ZipsRacingElectric/VCU-ZR25-Senior-Design/README.md

# Vehicle Control Unit - ZR25 - Senior Design Project
The VCU contains the control algorithms for the powertrain.

## Todo
See the Issues tab for an up-to-date list.

## Building the project on a demo board

## RTOS Strucutre
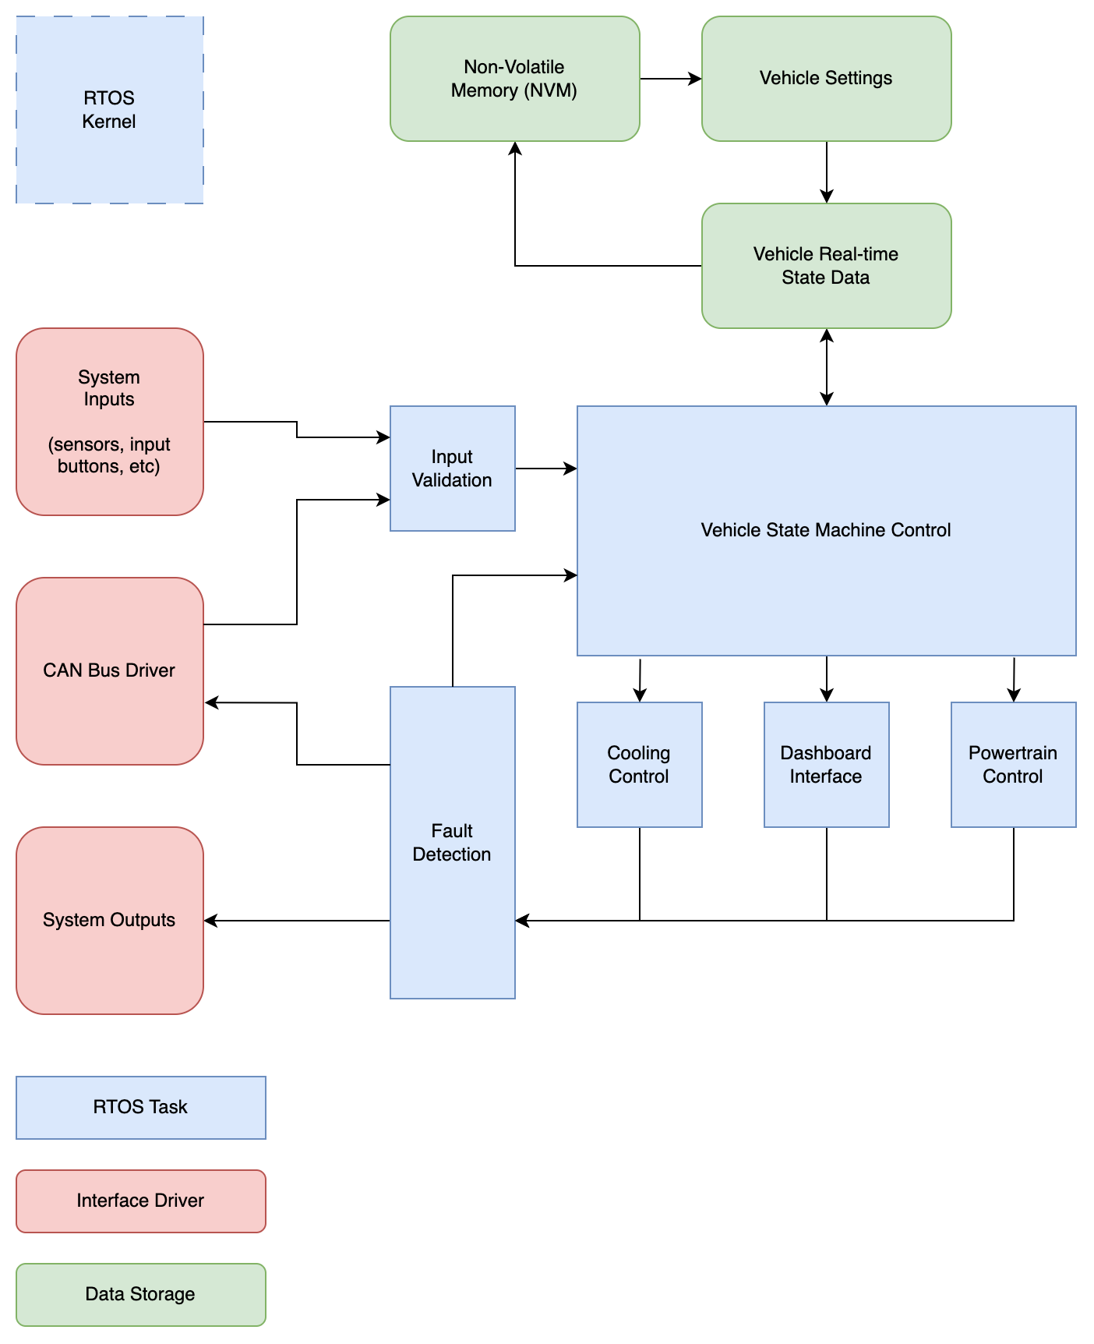
[picture p1: images/Microcontroller State Diagram.png]
RTOS structure for VCU
