ZipsRacingElectric/VCU-ZR25-Senior-Design/demos/powersupply/circuit_sketch.jpg

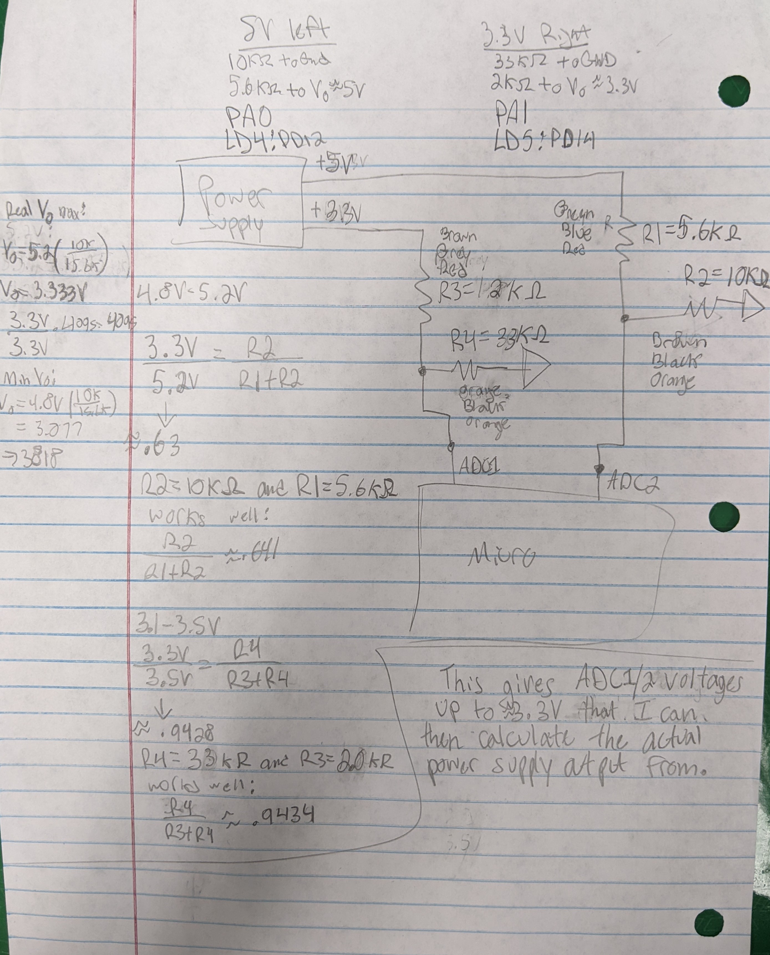
demos/powersupply/circuit_sketch.jpg
