ZipsRacingElectric/VCU-ZR25-Senior-Design/(threads)

Thread 2 (2025-01-28):

State Machine

bglen, 2025-01-28:
Implement State Machine (see flow chart for state machine)

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

- per discussion, eliminate lockout state

- in 1, the two conditions are 3.3V_SHUTDOWN_LOOP_IN must be logic high, and no faults. No faults can be determined by checking if the variable that controls ~3.3V_VCU_FAULT is logic low. Note that in the Low Voltage State, ~3.3V_VCU_FAULT can be either logic 1 or 0.

- in 2, the start signal is 3.3V_START_BUTTON_INPUT. Also, for the braking condition, the sensor driver code should have a variable that is true if the brakes are pressed hard enough and the line pressure is above a certain threshold.

- the 3 operation is really two separate operations:

   1: Under normal operation, one of the E-stops is opened. Per the shutdown loop diagram below, this will drop the 3.3V_SHUTDOWN_LOOP_IN signal low, indicating that the VCU should be put in Low Voltage State. The VCU should not change the  ~3.3V_VCU_FAULT signal (keeping it logical 1, and the relay stays closed).

   2: If a fault is detected, the ~3.3V_VCU_FAULT goes logic low, opening the relay. this causes the vehicle high voltage to turn off, and the VCU should be put into Low Voltage State.  3.3V_SHUTDOWN_LOOP_IN may either be logical 1 or 0 in this condition.

- The relay essentially is only opened by the presence of a fault, and can only be closed via the presence of the 3.3V_SHUTDOWN_LOOP_RESET signal.

- 4 no longer relevant.

Shutdown Loop wiring in vehicle:

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

purifiedbagels, 2025-02-20:
Updated the state machine, removed 4 and 5, updated wording of 3

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

purifiedbagels, 2025-02-22:
@bglen Is "driver presses the brakes" the mechanical brakes engaged that you reference in #9 or is it based on the same threshold as the brake light

purifiedbagels, 2025-03-11:
Pseudo-tested with manually setting flags via callbacks, works in itself and dependent on other tasks working properly

Closed 2025-03-11.

Thread 3 (2025-01-28):

CAN Control - Inverter / Motors

bglen, 2025-01-28:

bglen, 2025-03-08:
@tetrahedron341 Update on CAN bus network layout:

Plan on using one of the CAN transiever networks soley for communication between VCU and the 4 inverters - this is due to their "finicky" nature and tendancy of giving can message errors with other stuff on the bus.

The second CAN bus will have everything else on it, including the datalogging node. This means that the VCU will eventually need to act as a bridge and re-transmit inverter CAN messages onto the second bus. Besides the datalogger, the only other node that may use inverter messages might be the dashboard.

Both buses will have the VCU be the starting node, so both terminations will be active.

Thread 4 (2025-01-28):

I2C - Get steering angle sensor working

bglen, 2025-01-28:
Demo code never worked - may be due to bad steering angle sensor PCB

bglen, 2025-02-22:
[AM4096D02_09 (2).pdf](https://github.com/user-attachments/files/18917455/AM4096D02_09.2.pdf)

[slva689 (1).pdf](https://github.com/user-attachments/files/18917456/slva689.1.pdf)

Cole mentioned that the device is configured via I2C, but I should check if it can also be read through I2C

purifiedbagels, 2025-04-02:
any update on this?

Thread 9 (2025-02-18):

Control of motor torque from driver input plausibility

bglen, 2025-02-18:
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

- APPS pedal percent accessed through struct APPSSensor_t.percent that is returned from get_apps_data(void) function
- The brake threshold required to meet the "mechanical brakes engaged" requirement is not directly defined in the rules, so that is up to us to decide. Generally it should be pretty high so we don't trigger this while driving, but low enough so this functionality can be tested easilly. Probably around 50-75% of the max brake pressure.
- A bool variable checking for brake threshold is not currently part of the BPSSensor_t struct. This functionality should be added to driver_sensors.c

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
For APPS sensors:
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

- bool variables for plausibility are accessed through APPSSensor_t & BPSSensor_t structs returned from get_apps_data(void) and bool plausible
- In the past we've used the 100 ms delay between an implausibility & reducing motor torque requests as a way to avoid accidentally shutting down motors from plausibility issues caused by analog signal noise
- Generally, when a plausibility is detected, a 100 ms timer is started. Until then, motor torque control still uses the sensor outputs. If plausibility goes away, timer is reset
- The VCU fault does not need to be triggered, as this would open the shutdown loop and require a vehicle reset.

bglen, 2025-02-18:
Note: this functionality is separate from any torque vectoring control, so it could be part of a fault checking task, or torque command verification that comes after TV.

bglen, 2025-02-22:
> for the plausability - if the VCU fault doesn't need to be triggered then how is the shutdown loop being opened? I thought the way for the VCU to open the shutdown loop was with VCU fault

Correct, it would not open the shutdown loop. I should clarify that is the desired functionality in this case; a pedal plausibility issue will just cause the torque request CAN message sent to the inverter to be 0 Nm for each motor, but the high voltage will still be active.

bglen, 2025-02-22:
Faults which open the shutdown loop relay and faults that do not should be clarified in a table in #13

Closed 2025-04-02.

Thread 13 (2025-02-20):

Fault Checking Task

purifiedbagels, 2025-02-20:
There should probably be a separate RTOS task that handles fault checking

- Should be given information by various sensor tasks to determine faults
- Talks to fsm and/or vehicle data to determine state transitions and pin outputs

bglen, 2025-02-22:
I imaging #9 would be one of many checks that are carried out in this fault task?

bglen, 2025-02-22:
TODO: create a table of faults, determine which ones should open the shutdown loop, which should not, and what the expected functionality should be for each fault condition

bglen, 2025-03-16:
[VCU Faults.xlsx](https://github.com/user-attachments/files/19274600/VCU.Faults.xlsx)

purifiedbagels, 2025-03-17:
I will work on adding these

Thread 14 (2025-02-20):

Engineering Requirements Not Addressed

purifiedbagels, 2025-02-20:
List of engineering requirements yet to be addressed - implemented or not in issues:

- **1.1.9** The system shall provide a method of switching between different “control modes” for the powertrain, which can be selected by the driver (See Table 27 in Appendices).
- **1.1.11** Per FSAE rule T.3.4 the system shall activate a brake light on the rear of the vehicle based on of the following conditions... _(should be addressed when updating driver_sensors.c and/or fault detection_
- **1.1.12** The system shall control water pump(s) and radiator fan(s) associated with the vehicle’s cooling system in the following ways...
- **1.1.13** The system shall not command the powertrain to draw more than 80 kW of power from the high voltage battery output terminals, per FSAE 2025 rule EV.3.3.1 & EV3.4.1. _(not sure how we do this)_
- **1.1.15** The system shall be no larger than L x W x H (TBD#5) and the system's total mass shall not exceed (TBD#6) kg. _(is this already done?)_
- **1.1.16 - 1.1.18** Are these electrical things already done?
- **1.1.19** The system shall record and store its settings (tuning parameters, etc.) across power cycles. _(I'm assuming the VCU has to store in memory)_
- **1.1.21** Real-Time Processes _referring to update rates_
- **1.1.22** I believe we're on our way with all of these
- **1.1.23** The system shall be waterproof. _(is this also already done?)_

These are the ones I believe aren't totally addresses or that I just don't know of. Thoughts in italics

bglen, 2025-02-22:
I've added these requirements to the relevant issues.

- For 1.1.13, the torque vectoring algorithm selected by the torque control handler/task will be responsible for this (AKA Ryan and my will address this in the control system)
- 1.1.15 I thought we removed, but essentially yes it will fit in the vehicle. I don't have specific dimensions or weight requirements
- 1.1.19 will need to be addressed in the tasks handling vehicle data. Just a heads up - the control algorithms will require some lookup tables stored in memory. These tables will hold data like controller gains, tire forces, and electric motor power losses. Most of these tables are "set and forget" and can be sent to memory like flash. Some will be tuning parameters that may be written multiple times, so EEPROM or other kinds of memory that can handle a lot of write cycles may be more appropriate. We will also have to determine how to load this data onto the micro (i.e, reprogram or send it over CAN / USB C, etc..)

Closed 2025-04-02.

Thread 15 (2025-02-21):

Dashboard Interface Task

purifiedbagels, 2025-02-21:

bglen, 2025-02-21:
For basic functionality:
- the VCU will not communicate with the MoteC LCD display. Instead, any data this display needs, it will grab it from the data-logging messages on the CAN bus through its own programming.

**Start button input (3.3V_START_BUTTON_INPUT):**
- used for entering Ready to Drive mode

**Dashboard VCU Fault LED (3.3V_DASH_INPUT_1):**
- There is an LED on the dash that can light up whenever there is a VCU fault we want to display. 3.3V_DASH_INPUT_2 technically should be configured as a digital output for this. Whenever there is a fault that triggers the ~3.3V_VCU_FAULT opening the shutdown loop relay, we should turn this LED on also so we can debug what happened.
- The reason we don't send the ~3.3V_VCU_FAULT signal directly to this LED is because there might be a minor fault (APPS for example), that we want to trigger the LED but don't want the shutdown loop relay opening and causing the car to fall out of high voltage.

**DRS enable / disable button (3.3V_DASH_INPUT_2):**
- This allows the driver to toggle the drag reduction system. The VCU will have to keep track of the DRS enable state, and change it when this button is pressed.
- The DRS system is on a separate board connected to the CAN bus. The VCU will have to send a CAN message over the bus when the DRS enable state changes. (TBD) I don't know if this message is supposed to get sent at a regular interval, or only when the state changes (and some kind of handshake is done).
- The DRS state can be toggled regardless of the VCU state.

**Torque limit Increase button (3.3V_DASH_INPUT_3):**
- When pressed the torque limit variable increases by some percentage (lets say 10% for now)
- The torque limit variable will be part of the torque control handler, is a percentage 0 to 100% that gets passed to whatever algorithm is calculating the motor torques.
- torque limit variable should be limited between 10 to 100%. It might just be an integer that is interpreted by the algorithm as a percentage.

**Torque limit decrease button (3.3V_DASH_INPUT_4):**
- When pressed the torque limit variable decreases by some percentage (lets say 10% for now)

purifiedbagels, 2025-02-22:
@bglen I'd assume that if the shutdown loop opens externally, we should also turn on DASH_INPUT_2?
Actually thinking about this more, how does this work with configuring input 2 as an output for the VCU fault but as an input otherwise. It can only be one at a time, so do we assume that the dashboard will just keep the LED on even when we have to switch it back to an input, where the signal would go low?

purifiedbagels, 2025-02-22:
Yeah I'm a bit confused. The schematics show that the dash inputs are actual inputs, but 1 is an output and 2 sometimes is?

bglen, 2025-02-24:
That was a mistake, under **Dashboard VCU Fault LED (3.3V_DASH_INPUT_1):** I meant to write 3.3V_DASH_INPUT_1

The schematic calls these signals inputs, but in reality I should update it and call them GPIO as they can serve a more general purpose other than button inputs

purifiedbagels, 2025-02-24:
@tetrahedron341 Issue closed besides CAN

Closed 2025-04-02.

Thread 16 (2025-02-21):

Cooling System Task

purifiedbagels, 2025-02-21:

bglen, 2025-02-21:
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

4 outputs to control:
- 3.3V_PUMP_1_CONTROL
- 3.3V_PUMP_2_CONTROL
- 3.3V_FAN_1_CONTROL
- 3.3V_FAN_2_CONTROL

For now lets arbitrarily say that:
-  Pump 1 / Fan 1 cool the left side inverter & 2 left motors
-  Pump 2 / Fan 2 cool the left side inverter & 2 left motors

bglen, 2025-02-21:
Cooling system control:

All Pumps & Fans are turned on in the following conditions:
- The vehicle is in the Ready to Drive state

Pumps 1 /  Fan 1 can only turn off in the  following conditions:
- The left inverter temp drops below X, &
- The FL motor temp drops below X, &
- The RL motor temp drops below X

Pumps 2 /  Fan 2 can only turn off in the  following conditions:
- The right inverter temp drops below X, &
- The FR motor temp drops below X, &
- The RR motor temp drops below X

The idea is that if one of these components is overheated, we still want to cool it even if we turn the high voltage off.

bglen, 2025-02-21:
The temperature data is sent over the CAN bus in the following messages, which are sent every 16? Hz:

RL Inverter / Motor, CAN ID 0x500
RR Inverter / Motor, CAN ID 0x501
FL Inverter / Motor, CAN ID 0x502
FR Inverter / Motor, CAN ID 0x503

- Temperature sensor motor is the motor temp
- IGBT temperature is the inverter temp
- Temp internal and external should be ignored (not sure what these are)

see the CAN config table: https://github.com/ZipsRacingElectric/AMK-2025

purifiedbagels, 2025-02-21:
is the temperature being read by CAN? I don't see a pin for it

purifiedbagels, 2025-02-22:
@tetrahedron341 this is pretty CAN related, I wrote an outline and can do the GPIO side but you should do the CAN as I'm not familliar

bglen, 2025-02-22:
Scaling factors for the message data should be found in the inverter documentation; it should eventually be added as a column to the table in the AMK-2025 README.md

bglen, 2025-02-22:
Note: I forgot to include the additional condition in one of the above comments:

Each Pump/Fan pair should turn on if the inverters / motors they cool are above a certain temperature, regardless of VCU state. This is to catch the edge case where the car exits high voltage, the powertrain is still hot, so the cooling system is working, and then someone cycles low voltage power, causing the VCU to reset. In this case we want the cooling system to turn back on.

bglen, 2025-02-24:
TODO: figure out temperature setpoints

Closed 2025-04-02.

Thread 17 (2025-02-21):

Torque Control Task

purifiedbagels, 2025-02-21:
@bglen Not really sure what this entails and if this is on your end or Tetra and I's

bglen, 2025-02-21:
So for a first iteration:

This can be a placeholder for the future TV algorithm by simply scaling the APPS pedal percentage by a max torque variable to get the torque request. This can then be applied to each motor equally.

Next iteration:
- We will want to have multiple algorithms that we can select. One would essentially be the simple algorithm mentioned above, which we can call a limp mode
- Next we would have the torque vectoring algorithm. This probably will be some function or class with a PID implementation.
- For the handler that selects the algorithm, it would be a good idea to pass each algorithm a struct containing all the vehicle data the algorithm needs to compute. We could make this struct the same for all algorithms, and simpler controllers just wouldn't use all the data.

bglen, 2025-02-21:
From engineering requirements:

1.1.9 The system shall provide a method of switching between different “control modes” for the powertrain, which can be selected by the driver (See Table 27 in Appendices).

bglen, 2025-02-22:
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

First attempt at the kind of data we would want to pass to the control algorithm in an input struct (or with multiple structs). I've put this spreadsheet Torque Control Struct.xlsx on the DT10 drive and will update it as we figure it out.

I can also see an initialization struct being used to send constant data needed by the control algorithms (things like constant vehicle parameters, like mass). Could also just be hard coded.

purifiedbagels, 2025-02-24:
instead of creating a new struct, it's likely that this will all be in the vehicledata struct that the algorithm can get

purifiedbagels, 2025-04-02:
closing because this is no longer specifically different from the #19

Closed 2025-04-02.

Thread 18 (2025-02-21):

Brake Light Functionality

bglen, 2025-02-21:
from engineering requirements:

1.1.11 Per FSAE rule T.3.4 the system shall activate a brake light on the rear of the vehicle based on of the following conditions... (should be addressed when updating driver_sensors.c and/or fault detection

- Not sure if this needs a separate RTOS task or can be part of an existing one (driver sensor handling for example)
- Must operate regardless of VCU state
- trigged by the brake pressure exceeding a certain threshold that is stored in driver_sensors.c
- this brake pressure threshold should NOT the same as the one discussed in #9 - that threshold will be too high. Instead this one can be low, like 5% of maximum brake pressure
- Toggle 3.3V_BRAKE_LIGHT_CONTROL to active brake light circuit

Closed 2025-02-22.

Thread 19 (2025-02-24):

Torque Vectoring Algorithm

bglen, 2025-02-24:
Created this to separate implementation of the actual torque vectoring algorithm and the RTOS task that runs the algorithm

bglen, 2025-03-22:
**Torque Optimization**

Storage of Tire Model lookup tables, Electric motor power loss lookup tables

bglen, 2025-04-06:
**Reference Yaw Rate Calculation**

- [ ] Implement tetra's LUT interpolation functions for the steering angle LUT
- [ ] in MATLAB convert the steering LUT to directly use radians, get rid of conversion functions
- [ ] Update ref_gen.h ref_gen.c in HIL_test to use vehicle_data
- [ ] Algorithm for calculatign longitudinal acceleration reference value

bglen, 2025-04-06:
**PID Implementation**

- [ ] Gain scheduling using the gain LUT
- [ ] Integrator anti-windup

Thread 21 (2025-02-27):

Vehicle Data Task

bglen, 2025-02-27:
Not entire sure what the plan to implement this is, so edit as necessary:

1. Data collection via CAN bus and input drivers
2. Data filtering / saturation

bglen, 2025-03-16:
**GPS**
Need to capture and record data from the GPS to be used by the control system

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

Data that is relevant to us and should be grabbed from the messages:
- Speed (needs to be converted to m/s)
- GPS Status
- Heading motion (convert to rad)
- Heading vehicle (convert to rad)
- Z angle rate (this is yaw rate, convert to rad/s)
- X acceleration (convert to m/s^2)
- Y acceleration (convert to m/s^2, and invert to put it in the control system coordinate system)

Notes:
- some of the data will be signed
- these messages will be sent at 200 Hz from GPS
- It is very important that we keep track of the GPS status in the 2nd message. It may take like 20 seconds after the car is turned on for the GPS to get a good lock, and then we can reliably use the data to drive. The VCU should trigger a fault that turn the fault LED on the dash on until the GPS lock is found (fault LED is triggered by 3.3V_DASH_INPUT_1)

[ECUMaster GPStoCAN V2 Manual (1).pdf](https://github.com/user-attachments/files/19274239/ECUMaster.GPStoCAN.V2.Manual.1.pdf)

bglen, 2025-03-16:
**MoTeC VIM**

[todo]

bglen, 2025-03-16:
**Battery Management System**

bglen, 2025-03-16:
**Initialization of vehicle data values**

Before data is populated from sensors, we could:
1. initialize everything to 0. We would have to avoid dividing by zero from calling functions before real data gets populated (ex: enabling control algorithm and passing 0 data to it)
2. initialize everything to NaN (from math.h). Then our math functions, specifically torque handling task would check if passed data is NaN via isnan() and handle the exception. We could also pass NaN when a sensor faults (ex: out of bounds)

purifiedbagels, 2025-03-17:
A vehicledata task has been started that all tasks call to to update the data, will need to be updated based on this issue and I think a lot of what is left to store is from CAN. Fault mgmt task can check this data for faults

Thread 29 (2025-04-06):

HIL Test Firmware Tasks

bglen, 2025-04-06:
HIL Test to verify the process works with a test model
- [ ] Initialize PID controller & Can bus @ 1 Mbps
- [ ] Receive CAN message w/ ID 0x123 containing  input_data, output_data, time_step and assign variables
- [ ] Run PID loop, compute controller output
- [ ] Send CAN message w/ ID 0x124 containing controller output

bglen, 2025-04-06:
HIL Test with Yaw Controller

- [ ] Update Receive Message(s) with input data
- [ ] Create Lookup tables for steering system and PI gains
- [ ] Lookup table functions, including interpolation of 1D tables
- [ ] Implement Reference Generation Algorithm
- [ ] Implement PI Controller with gain scheduling
- [ ] Update output message with controller output Mz_tv
