ZipsRacingElectric/VCU-ZR25-Senior-Design/docs/VCU Schematic.pdf

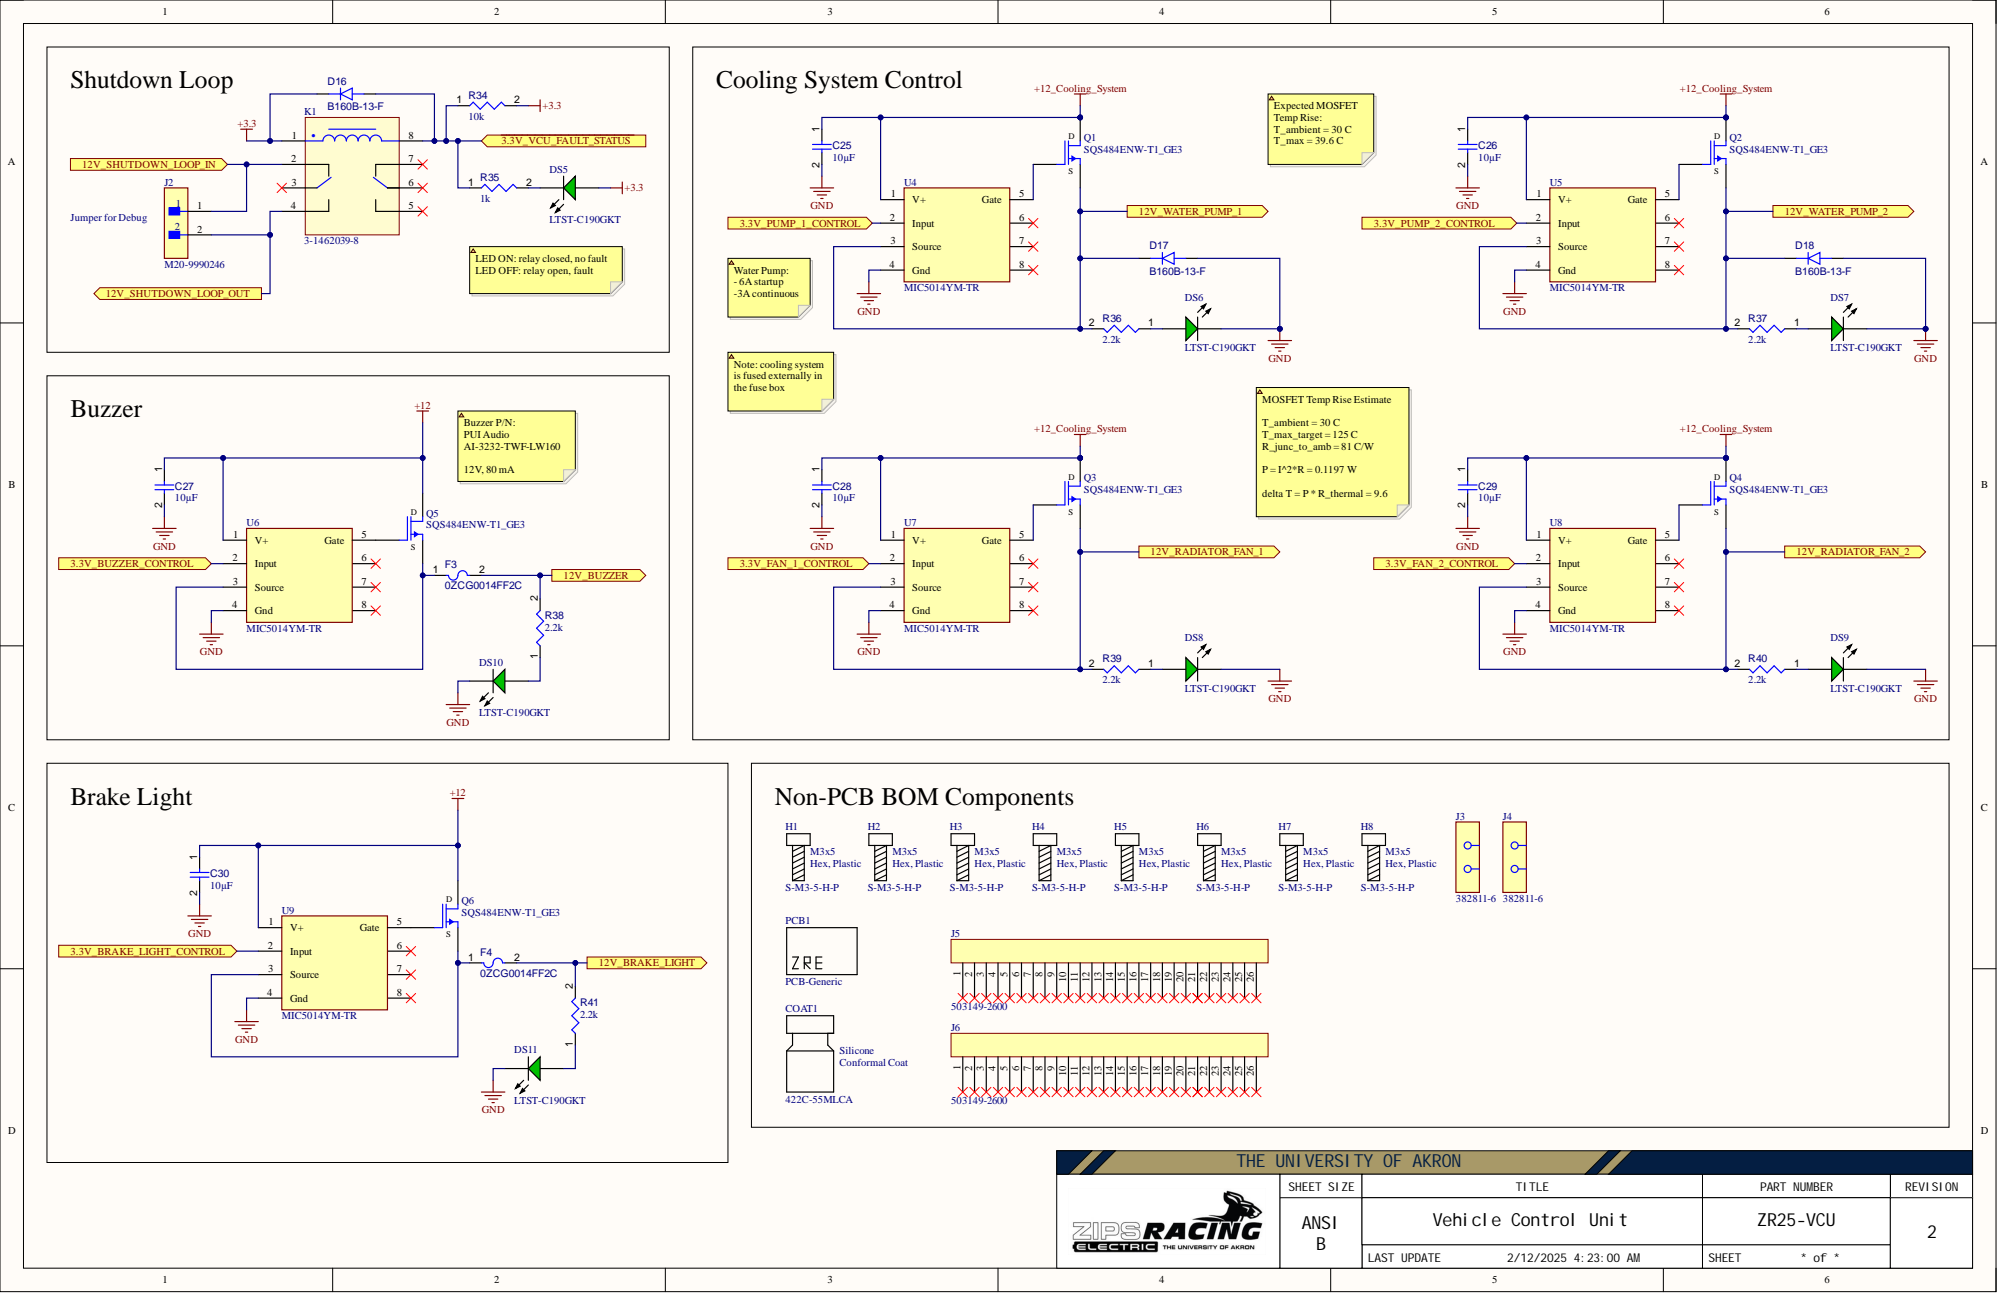
[picture p3: page 1]

LED ON: relay closed, no fault
LED OFF: relay open, fault

Note: cooling system
is fused externally in
the fuse box

MOSFET Temp Rise Estimate

Non-PCB BOM Components

THE UNIVERSITY OF AKRON

SHEET SIZE | TITLE | PART NUMBER | REVISION
ANSI B | Vehicle Control Unit | ZR25-VCU | 2

LAST UPDATE 2/12/2025 4:23:00 AM | SHEET * of *

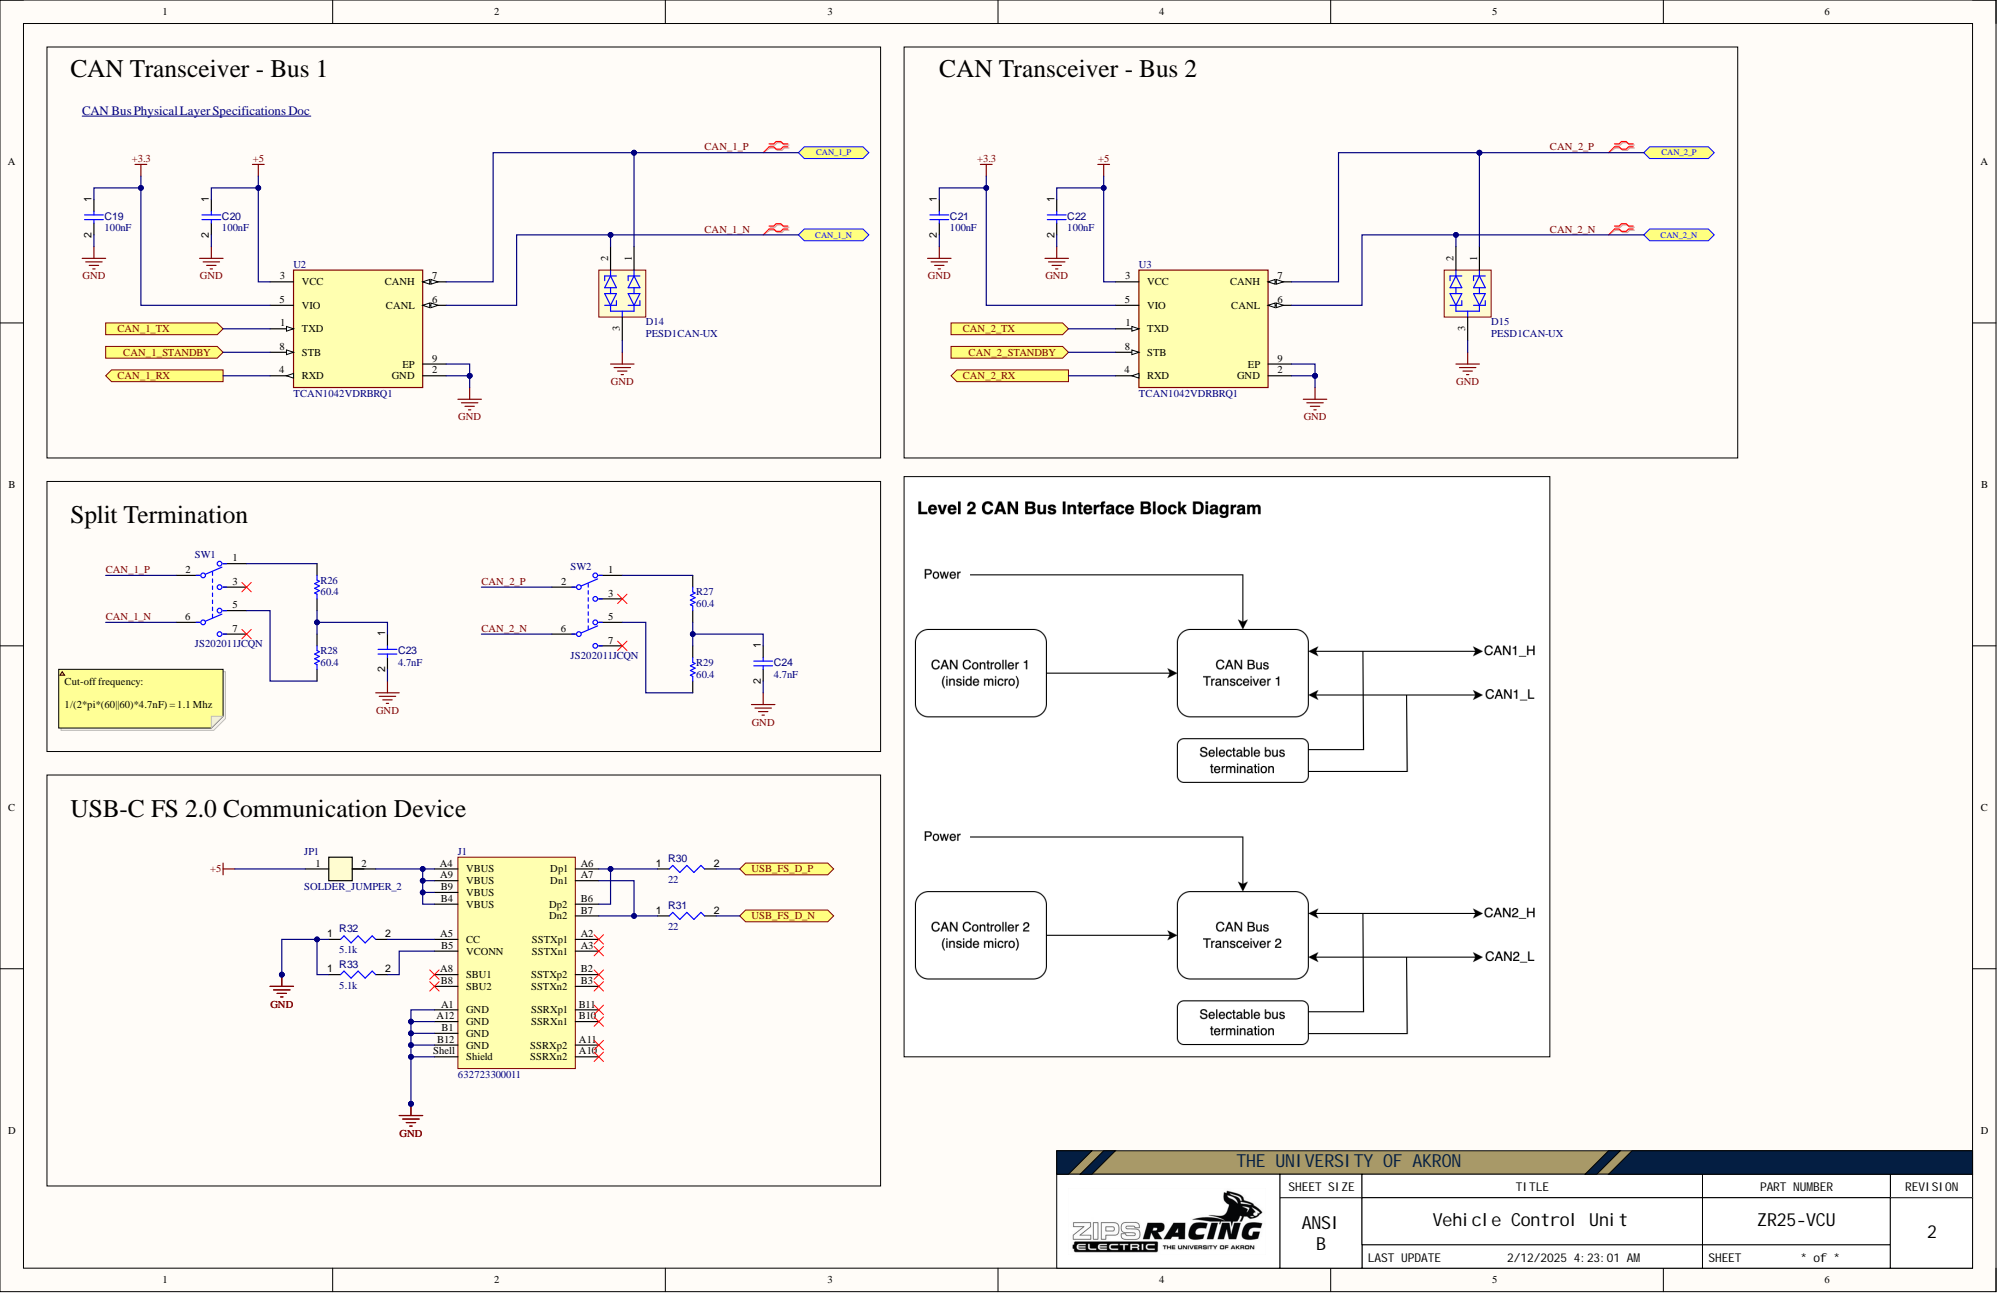
[picture p4: page 2]

CAN Bus Physical Layer Specifications Doc (https://www.ti.com/lit/pdf/slla270)

USB-C FS 2.0 Communication Device

THE UNIVERSITY OF AKRON

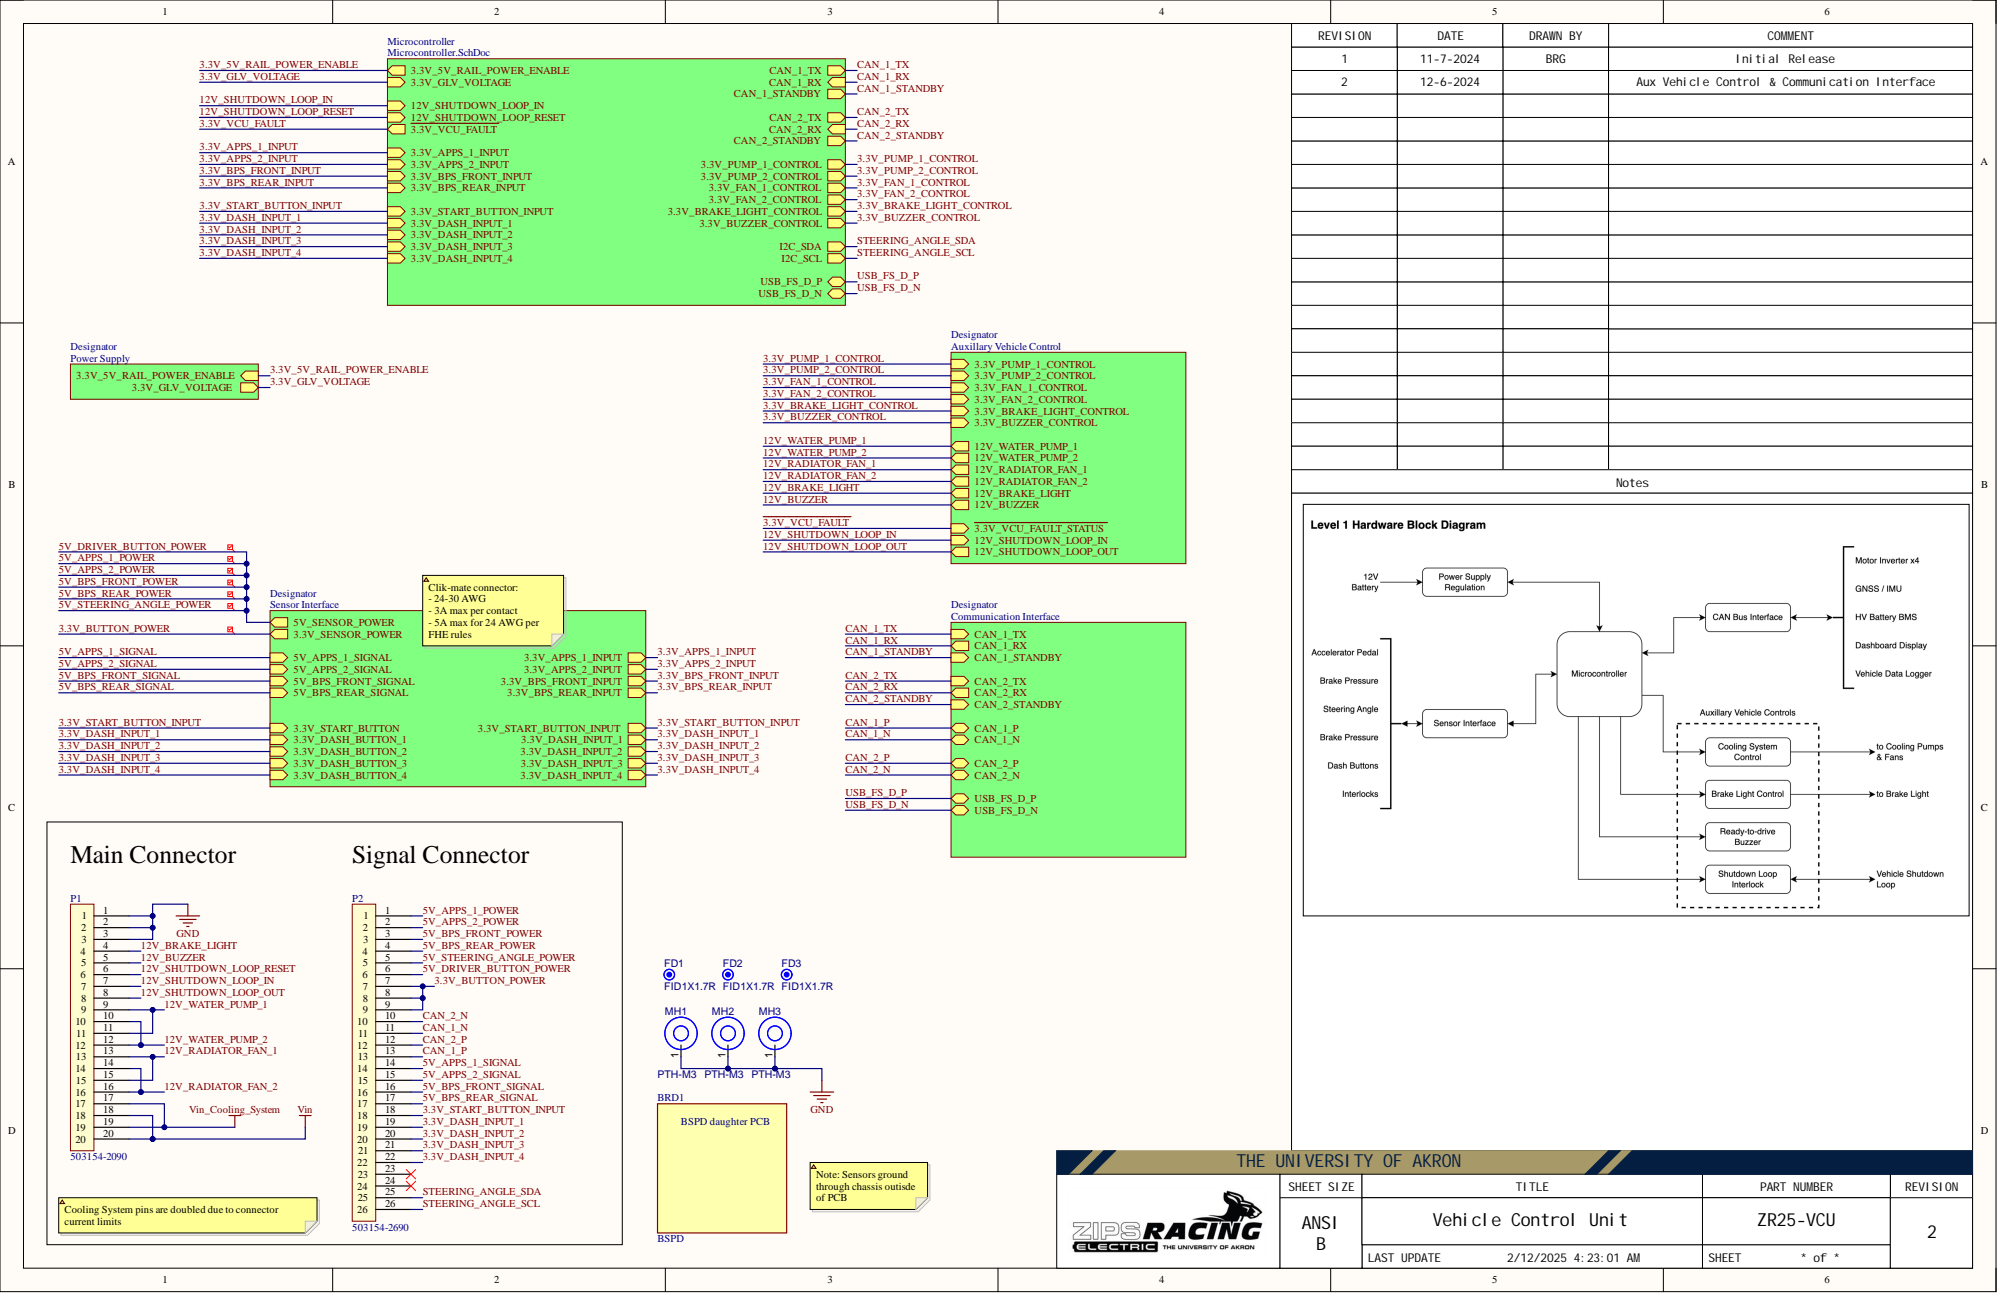
[picture p5: page 3]
Power Supply; Sensor Interface; Communication Interface; Auxillary Vehicle Control; Main Connector; Signal Connector

REVISION | DATE | DRAWN BY | COMMENT

11-7-2024 | BRG | Initial Release

12-6-2024 | | Aux Vehicle Control & Communication Interface

Clik-mate connector:
- 24-30 AWG
- 3A max per contact
- 5A max for 24 AWG per
FHE rules

BSPD daughter PCB

THE UNIVERSITY OF AKRON

Note: Sensors ground
through chassis outisde
of PCB

Cooling System pins are doubled due to connector
current limits

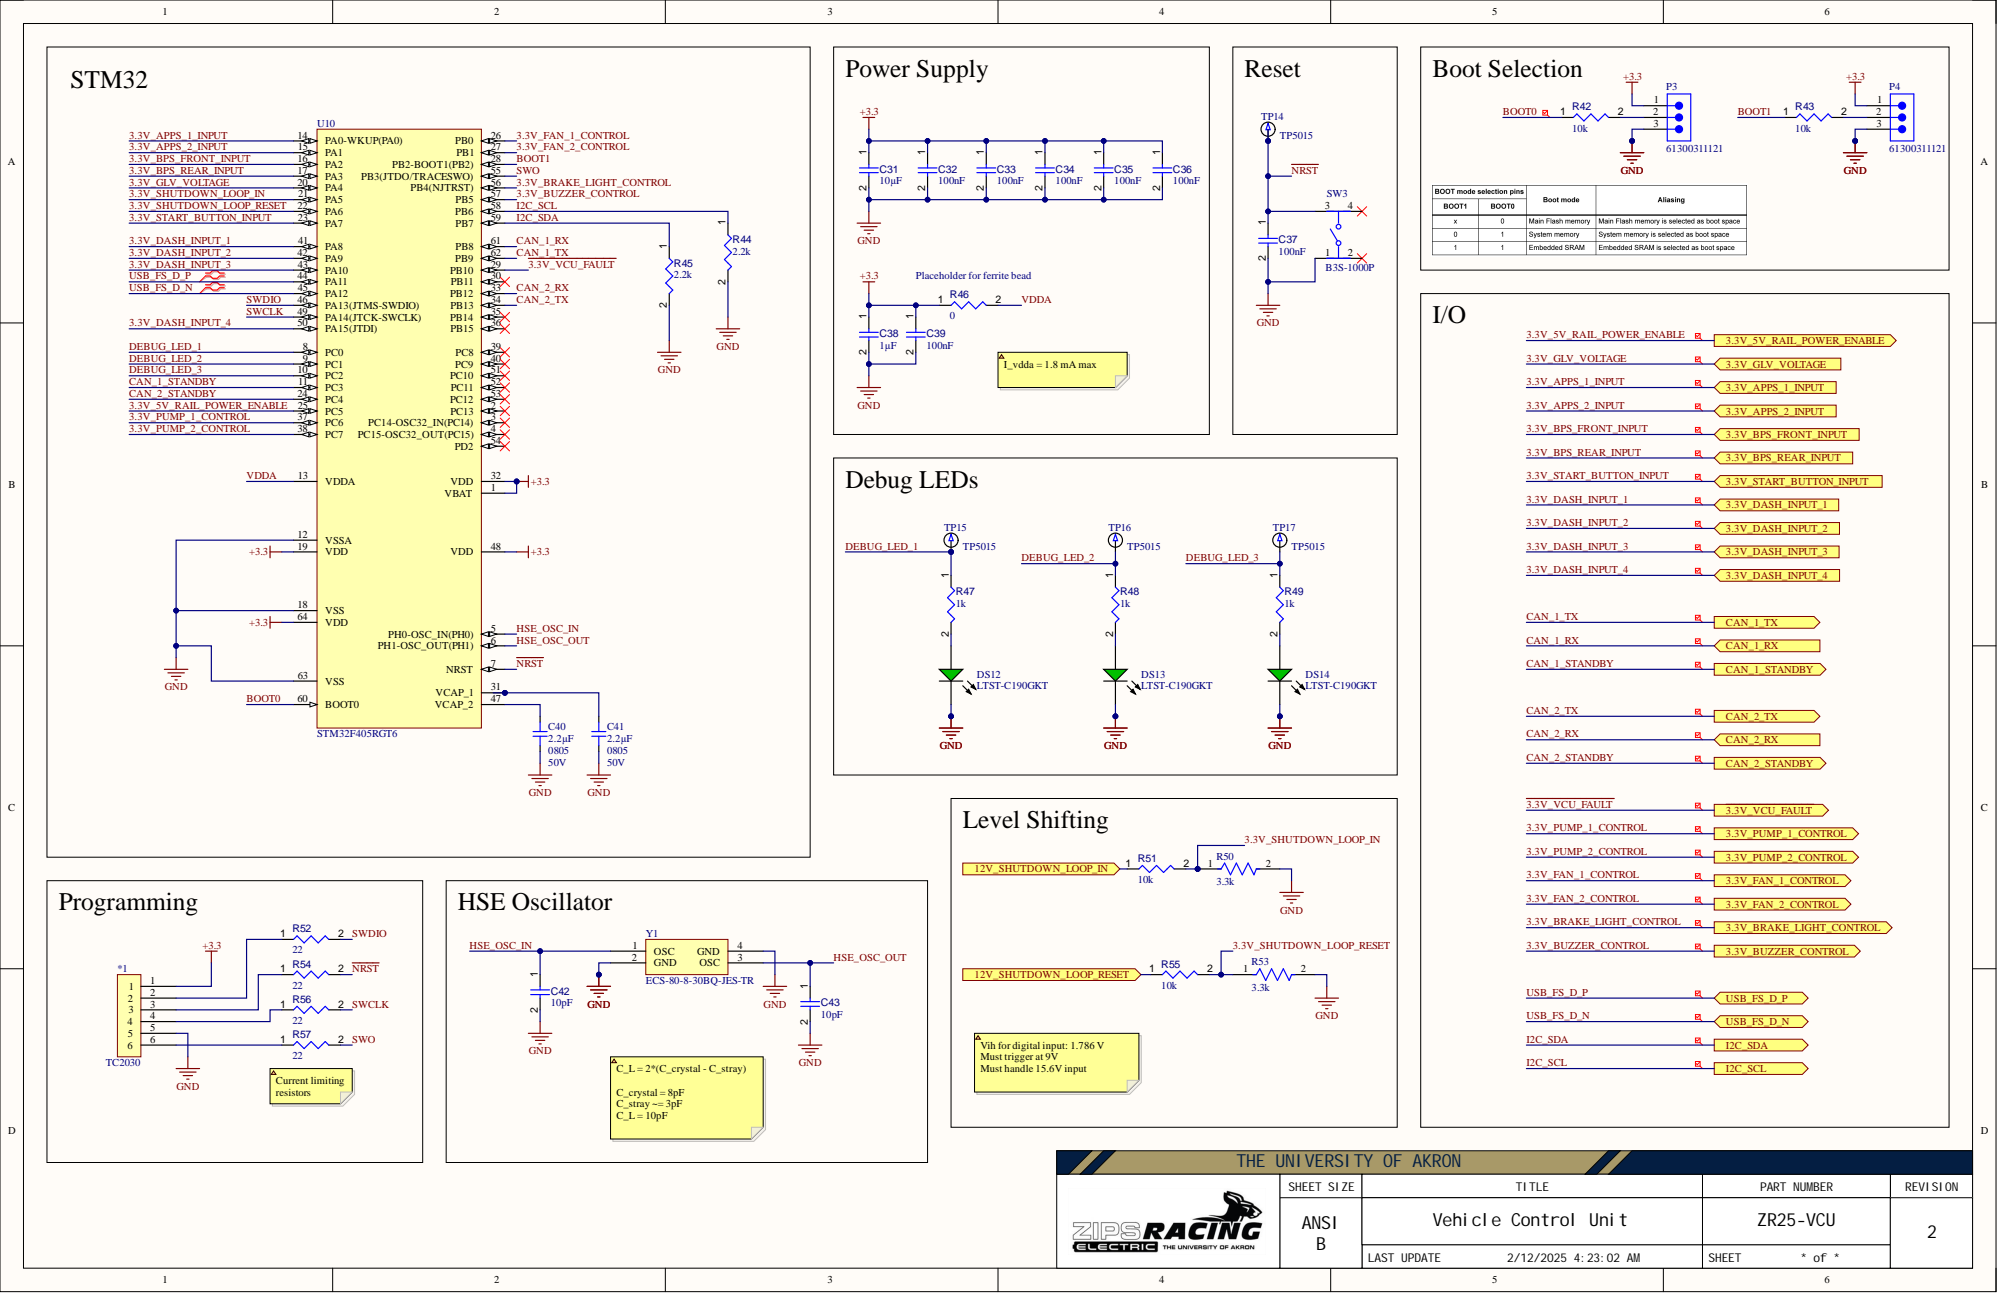
[picture p6: page 4]

Placeholder for ferrite bead

VDD 19

VDD 64

Vih for digital input: 1.786 V
Must trigger at 9V
Must handle 15.6V input

THE UNIVERSITY OF AKRON

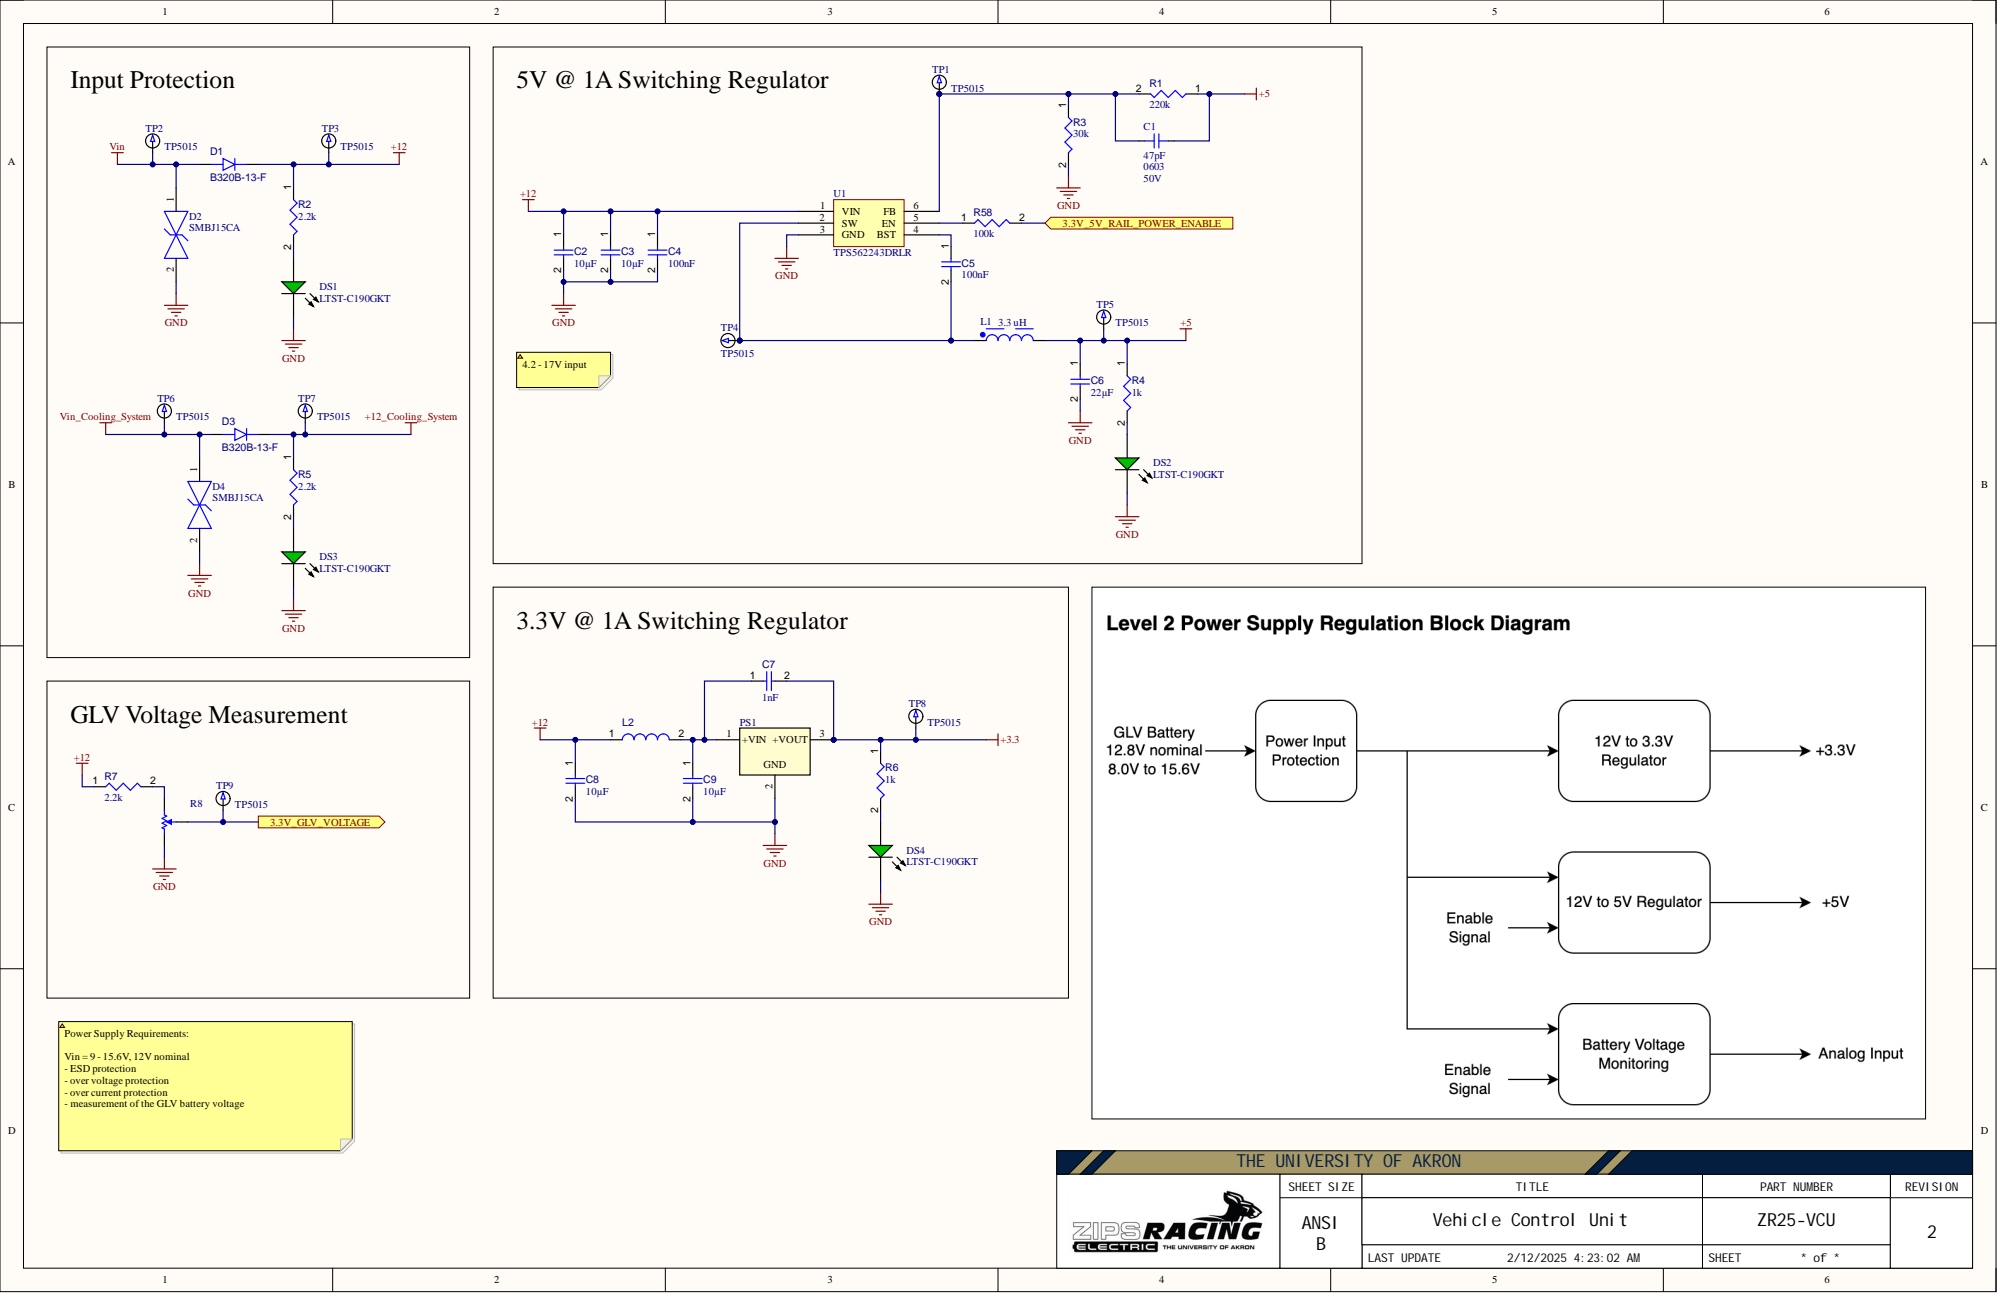
[picture p7: page 5]

Vin = 9 - 15.6V, 12V nominal
- ESD protection
- over voltage protection
- over current protection
- measurement of the GLV battery voltage

THE UNIVERSITY OF AKRON

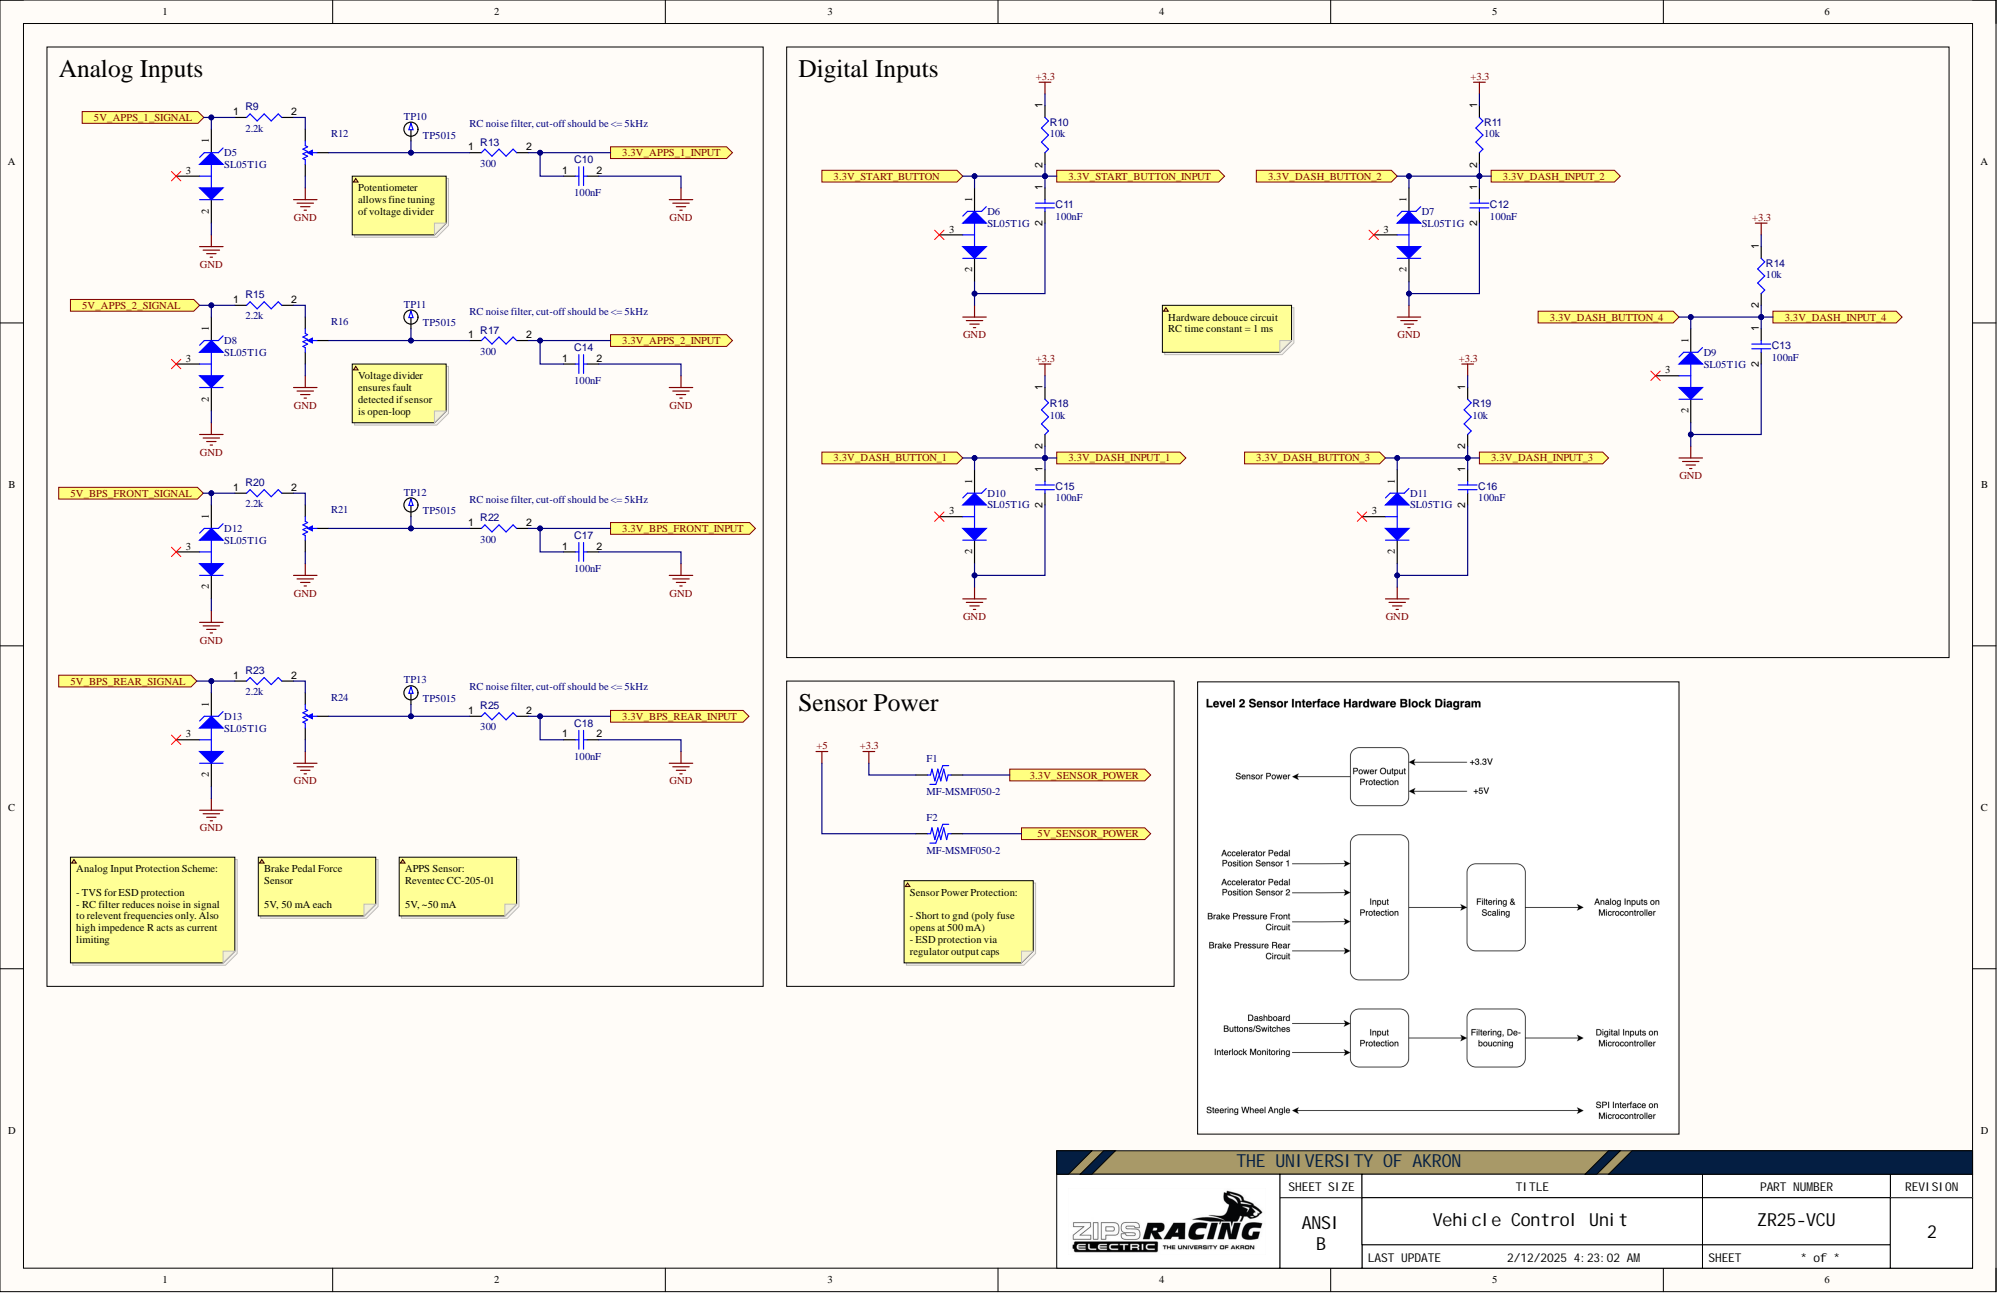
[picture p8: page 6]

RC noise filter, cut-off should be <= 5kHz

Hardware debouce circuit
RC time constant = 1 ms

Analog Input Protection Scheme:

- TVS for ESD protection
- RC filter reduces noise in signal
to relevent frequencies only. Also
high impedence R acts as current
limiting

- Short to gnd (poly fuse
opens at 500 mA)
- ESD protection via
regulator output caps

THE UNIVERSITY OF AKRON
