ZipsRacingElectric/VCU-ZR25-Senior-Design/VCU-ZR25/VCU-ZR25.ioc

Mcu.UserName=STM32F405RGTx
PA0-WKUP.GPIO_Label=APPS_1
PA0-WKUP.Signal=ADCx_IN0
PA1.GPIO_Label=APPS_2
PA1.Signal=ADCx_IN1
PA10.GPIO_Label=DASH_INPUT_3
PA10.Signal=GPXTI10
PA11.Signal=USB_OTG_FS_DM
PA12.Signal=USB_OTG_FS_DP
PA13.Signal=SYS_JTMS-SWDIO
PA14.Signal=SYS_JTCK-SWCLK
PA15.GPIO_Label=DASH_INPUT_4
PA15.Signal=GPXTI15
PA2.GPIO_Label=BPS_FRONT
PA2.Signal=ADCx_IN2
PA3.GPIO_Label=BPS_REAR
PA3.Signal=ADCx_IN3
PA4.GPIO_Label=GLV_BATTERY
PA4.Signal=ADCx_IN4
PA5.GPIO_Label=VCU_SHUTDOWN_LOOP_IN
PA5.Signal=GPXTI5
PA6.GPIO_Label=VCU_SHUTDOWN_LOOP_RESET
PA6.Signal=GPXTI6
PA7.GPIO_Label=START_BUTTON
PA7.Signal=GPXTI7
PA8.GPIO_Label=DASH_INPUT_1
PA8.Signal=GPIO_Output
PA9.GPIO_Label=DASH_INPUT_2
PA9.Signal=GPXTI9
PB0.GPIO_Label=FAN_1_CONTROL
PB0.Signal=GPIO_Output
PB1.GPIO_Label=FAN_2_CONTROL
PB1.Signal=GPIO_Output
PB10.GPIO_Label=VCU_FAULT
PB10.Signal=GPIO_Output
PB12.Signal=CAN2_RX
PB13.Signal=CAN2_TX
PB2.GPIO_Label=BOOT_1
PB2.Signal=GPXTI2
PB3.Signal=SYS_JTDO-SWO
PB4.GPIO_Label=BRAKE_LIGHT_CONTROL
PB4.Signal=GPIO_Output
PB5.GPIO_Label=BUZZER_CONTROL
PB5.Signal=GPIO_Output
PB6.Signal=I2C1_SCL
PB7.Signal=I2C1_SDA
PB8.Signal=CAN1_RX
PB9.Signal=CAN1_TX
PC0.GPIO_Label=DEBUG_LED_1
PC0.Signal=GPIO_Output
PC1.GPIO_Label=DEBUG_LED_2
PC1.Signal=GPIO_Output
PC2.GPIO_Label=DEBUG_LED_3
PC2.Signal=GPIO_Output
PC3.GPIO_Label=CAN_1_STANDBY
PC3.Signal=GPIO_Output
PC4.GPIO_Label=CAN_2_STANDBY
PC4.Signal=GPIO_Output
PC5.GPIO_Label=RAIL_POWER_ENABLE_5V
PC5.Signal=GPIO_Output
PC6.GPIO_Label=PUMP_1_CONTROL
PC6.Signal=GPIO_Output
PC7.GPIO_Label=PUMP_2_CONTROL
PC7.Signal=GPIO_Output
PH0-OSC_IN.Signal=RCC_OSC_IN
PH1-OSC_OUT.Signal=RCC_OSC_OUT
