ZipsRacingElectric/VCU-ZR25-Senior-Design/VCU-ZR25/Core/Src/amk_can.c

/*
 * amk_can.c
 *
 * Defines the tasks in charge of CAN bus communication
 *
 *  Created on: Feb 11, 2025
 *      Author: bre17
 */
#include "amk_can.h"
#include "vehicle_data.h"
#include "fault_mgmt.h"
#include "cmsis_os.h"
#include "can_db.h"

static AMKState_t state;
extern osEventFlagsId_t amkEventFlagsHandle;

#define FORALL_MOTORS(mid) for (enum MotorId mid = 0; mid < 4; mid++)

AMKMotorState_t * MotorState(enum MotorId mid) {
	switch (mid) {
	case MOTOR_FL: return &state.motor_state_fl;
	case MOTOR_FR: return &state.motor_state_fr;
	case MOTOR_RL: return &state.motor_state_rl;
	case MOTOR_RR: return &state.motor_state_rr;
	default: return NULL;
	}
}

int16_t * MotorTorqueSetpoint(enum MotorId mid) {
	switch (mid) {
	case MOTOR_FL: return &state.torqueSetpoints.front_left;
	case MOTOR_FR: return &state.torqueSetpoints.front_right;
	case MOTOR_RL: return &state.torqueSetpoints.rear_left;
	case MOTOR_RR: return &state.torqueSetpoints.rear_right;
	default: return NULL;
	}
}

AMKMotorInfo_t * MotorInfo(enum MotorId mid) {
	switch (mid) {
	case MOTOR_FL: return &state.motor_info_fl;
	case MOTOR_FR: return &state.motor_info_fr;
	case MOTOR_RL: return &state.motor_info_rl;
	case MOTOR_RR: return &state.motor_info_rr;
	default: return NULL;
	}
}

AMKMotorStatistics_t * MotorStatistics(enum MotorId mid) {
	switch (mid) {
	case MOTOR_FL: return &state.motor_statistics_fl;
	case MOTOR_FR: return &state.motor_statistics_fr;
	case MOTOR_RL: return &state.motor_statistics_rl;
	case MOTOR_RR: return &state.motor_statistics_rr;
	default: return NULL;
	}
}

void update_vehicle_state(uint32_t timeout) {
	osMutexAcquire(vdb_inverter_lockHandle, timeout);
	VehicleData.inverter = state;
	osMutexRelease(vdb_inverter_lockHandle);
}

void motor_feedback_callback(uint32_t can_id, uint64_t message_int, void* void_motor_id) {
	enum MotorId mid = (enum MotorId) void_motor_id;
	AMKMotorInfo_t * motor_info = MotorInfo(mid);
	motor_info->motorFeedbackMessage.as_u64 = message_int;

	AMKControllerEventFlags_t flags = {0};
	switch (mid) {
	case MOTOR_FL: flags.flagBits.motor_feedback_fl_received = 1; break;
	case MOTOR_FR: flags.flagBits.motor_feedback_fr_received = 1; break;
	case MOTOR_RL: flags.flagBits.motor_feedback_rl_received = 1; break;
	case MOTOR_RR: flags.flagBits.motor_feedback_rr_received = 1; break;
	default: break;
	}
	osEventFlagsSet(amkEventFlagsHandle, flags.flagInt);
}

void motor_temperatures_callback(uint32_t can_id, uint64_t message_int, void* void_motor_id) {
	enum MotorId mid = (enum MotorId) void_motor_id;
	AMKMotorStatistics_t * stats = MotorStatistics(mid);
	CANMessage_AMK_RL_TEMPERATURES msg;
	msg.as_u64 = message_int;

	stats->temp_internal = msg.fields.RL_TEMPERATURE_INTERNAL;
	stats->temp_external = msg.fields.RL_TEMPERATURE_EXTERNAL;
	stats->temp_sensor = msg.fields.RL_TEMPERATURE_SENSOR_MOTOR;
	stats->temp_igbt = msg.fields.RL_IGBT_TEMPERATURE;

	AMKControllerEventFlags_t flags = {0};
	switch (mid) {
	case MOTOR_FL: flags.flagBits.motor_statistics_fl_update = 1; break;
	case MOTOR_FR: flags.flagBits.motor_statistics_fr_update = 1; break;
	case MOTOR_RL: flags.flagBits.motor_statistics_rl_update = 1; break;
	case MOTOR_RR: flags.flagBits.motor_statistics_rr_update = 1; break;
	default: break;
	}
	osEventFlagsSet(amkEventFlagsHandle, flags.flagInt);
}

void motor_power_consumption_callback(uint32_t can_id, uint64_t message_int, void* void_motor_id) {
	enum MotorId mid = (enum MotorId) void_motor_id;
	AMKMotorStatistics_t * stats = MotorStatistics(mid);
	CANMessage_AMK_RL_POWER_CONSUMPTION msg;
	msg.as_u64 = message_int;

	stats->actual_power = msg.fields.RL_ACTUAL_POWER_VALUE;
	stats->bus_voltage = msg.fields.RL_DC_BUS_VOLTAGE;
	stats->torque_current = msg.fields.RL_TORQUE_CURRENT_FEEDBACK;

	AMKControllerEventFlags_t flags = {0};
	switch (mid) {
	case MOTOR_FL: flags.flagBits.motor_statistics_fl_update = 1; break;
	case MOTOR_FR: flags.flagBits.motor_statistics_fr_update = 1; break;
	case MOTOR_RL: flags.flagBits.motor_statistics_rl_update = 1; break;
	case MOTOR_RR: flags.flagBits.motor_statistics_rr_update = 1; break;
	default: break;
	}
	osEventFlagsSet(amkEventFlagsHandle, flags.flagInt);
}

void initialize_motor_info(enum MotorId mid) {
	AMKMotorInfo_t * motor_info = MotorInfo(mid);
	uint32_t request_can_id, feedback_can_id, temperature_can_id, power_consumption_can_id;
	CAN_HandleTypeDef* canInterface;

	// Motor CAN IDs are all identically shifted by an offset
	uint32_t motor_can_offset;
	switch (mid) {
	case MOTOR_RL:
		motor_can_offset = 0;
		motor_info->isConfigured = true;
		break;
	case MOTOR_RR:
		motor_can_offset = 1;
		motor_info->isConfigured = false;
		break;
	case MOTOR_FL:
		motor_can_offset = 2;
		motor_info->isConfigured = false;
		break;
	case MOTOR_FR:
		motor_can_offset = 3;
		motor_info->isConfigured = false;
		break;
	default:
		motor_info->isConfigured = false;
		return;
	}

	request_can_id = CAN_DB_AMK_RL_MOTOR_REQUEST_ID + motor_can_offset;
	feedback_can_id = CAN_DB_AMK_RL_MOTOR_FEEDBACK_ID + motor_can_offset;
	temperature_can_id = CAN_DB_AMK_RL_TEMPERATURES_ID + motor_can_offset;
	power_consumption_can_id = CAN_DB_AMK_RL_POWER_CONSUMPTION_ID + motor_can_offset;
	canInterface = &hcan2;

	motor_info->isConfigured = true;
	motor_info->motorRequestMessageEntry = CANGetDbEntry(request_can_id);
	motor_info->motorFeedbackMessageEntry = CANGetDbEntry(feedback_can_id);
	motor_info->motorTemperaturesMessageEntry = CANGetDbEntry(temperature_can_id);
	motor_info->motorPowerConsumptionMessageEntry = CANGetDbEntry(power_consumption_can_id);
	motor_info->motorRequestMessage = (AMKMotorRequestMessage_t){0};
	motor_info->canInterface = canInterface;

	CANRegisterCallback(motor_info->motorFeedbackMessageEntry, motor_feedback_callback, (void*) mid);
	CANRegisterCallback(motor_info->motorTemperaturesMessageEntry, motor_temperatures_callback, (void*) mid);
	CANRegisterCallback(motor_info->motorPowerConsumptionMessageEntry, motor_power_consumption_callback, (void*) mid);
}

void update_motor(enum MotorId mid);

// Records the last tick on which a motor feedback message was received.
uint32_t lastTickFeedbackReceived[4];

// How long to wait between motor feedback messages before raising a fault.
uint32_t motorFeedbackTimeoutMilliseconds = 500;
uint32_t motorFeedbackTimeoutTicks;

void StartAMKTask(void *argument) {
	// Initialize state machines
	FORALL_MOTORS(mid)
		*MotorState(mid) = MOTOR_DISABLED;
	FORALL_MOTORS(mid)
		initialize_motor_info(mid);
	state.controller_state = MOTORS_DISABLED;
	update_vehicle_state(osWaitForever);
	FORALL_MOTORS(mid)
		lastTickFeedbackReceived[mid] = -1; // Have not gotten motor feedback yet.
	// Calculate the motor feedback timeout in OS ticks.
	motorFeedbackTimeoutTicks = osKernelGetTickFreq() * motorFeedbackTimeoutMilliseconds / 1000;


	while (1) {
		AMKControllerEventFlags_t flags;
		flags.flagInt = osEventFlagsWait(amkEventFlagsHandle, (AMKControllerEventFlags_t){.flagBits=AMK_FLAGS_ALL}.flagInt, osFlagsWaitAny, 10);
		uint32_t currentTick = osKernelGetTickCount();

		if (state.controller_state == MOTORS_DISABLED && flags.flagBits.start_motors) {
			// Begin startup sequence
			state.controller_state = STARTING_MOTORS;
			FORALL_MOTORS(id)
				*MotorState(id) = WAITING_FOR_SYSTEM_READY;
		}

		if (flags.flagBits.motor_feedback_fl_received) {
			lastTickFeedbackReceived[MOTOR_FL] = currentTick;
			update_motor(MOTOR_FL);
		}
		if (flags.flagBits.motor_feedback_fr_received) {
			lastTickFeedbackReceived[MOTOR_FR] = currentTick;
			update_motor(MOTOR_FR);
		}
		if (flags.flagBits.motor_feedback_rl_received) {
			lastTickFeedbackReceived[MOTOR_RL] = currentTick;
			update_motor(MOTOR_RL);
		}
		if (flags.flagBits.motor_feedback_rr_received) {
			lastTickFeedbackReceived[MOTOR_RR] = currentTick;
			update_motor(MOTOR_RR);
		}

		FORALL_MOTORS(mid) {
			uint32_t timeSinceLastTick = currentTick - lastTickFeedbackReceived[mid];
			if (timeSinceLastTick > motorFeedbackTimeoutTicks) {
				fault_flag_callback(FAULT_INDEX_INV_COM_FAILURE, 1);
			}
			else{
				fault_flag_callback(FAULT_INDEX_INV_COM_FAILURE, 0);
			}
		}

		update_vehicle_state(osWaitForever);
	}
}

int16_t convert_torque(float torque_newtonmeters) {
	return (int16_t)(MOTOR_TORQUE_UNITS_PER_NEWTONMETER * torque_newtonmeters);
}

void AMKSetInverterTorqueSetpoints(amkTorqueSetpoints setpoints) {
	state.torqueSetpoints = setpoints;
	update_vehicle_state(0);
}

void update_motor(enum MotorId mid) {
	AMKMotorState_t * motor_state = MotorState(mid);
	AMKMotorInfo_t * motor_info = MotorInfo(mid);
	uint16_t torque_setpoint = *MotorTorqueSetpoint(mid);
	if (!motor_info->isConfigured)
		return;
	AMKMotorFeedbackMessage_t feedback = motor_info->motorFeedbackMessage;

	switch (*motor_state) {
	case MOTOR_DISABLED: break; // Wait for start_motors event flag
	case WAITING_FOR_SYSTEM_READY:
		if (feedback.fields.SYSTEM_READY)
			*motor_state = READY_TO_SET_DC_ON;
		break;
	case READY_TO_SET_DC_ON:
		motor_info->motorRequestMessage.fields.DC_ENABLE = 1;
		*motor_state = WAITING_FOR_QUIT_DC_ON;
		break;
	case WAITING_FOR_QUIT_DC_ON:
		if (feedback.fields.QUIT_DC_ON)
			*motor_state = READY_TO_ENABLE;
		break;
	case READY_TO_ENABLE:
		motor_info->motorRequestMessage.fields.TORQUE_SETPOINT = 0;
		motor_info->motorRequestMessage.fields.NEGATIVE_TORQUE_LIMIT = 0;
		motor_info->motorRequestMessage.fields.POSITIVE_TORQUE_LIMIT = 0;
		motor_info->motorRequestMessage.fields.DRIVER_ENABLE = 1;
		motor_info->motorRequestMessage.fields.INVERTER_ENABLE = 1;
		*motor_state = WAITING_FOR_QUIT_INVERTER_ON;
		break;
	case WAITING_FOR_QUIT_INVERTER_ON:
		if (feedback.fields.QUIT_INVERTER)
			*motor_state = MOTOR_READY;
		break;

	case MOTOR_READY:
		motor_info->motorRequestMessage.fields.TORQUE_SETPOINT = torque_setpoint;
		motor_info->motorRequestMessage.fields.POSITIVE_TORQUE_LIMIT = MOTOR_POS_TORQUE_LIMIT;
		motor_info->motorRequestMessage.fields.NEGATIVE_TORQUE_LIMIT = MOTOR_NEG_TORQUE_LIMIT;
		break;

	case READY_TO_DISABLE:
		motor_info->motorRequestMessage.fields.TORQUE_SETPOINT = 0;
		motor_info->motorRequestMessage.fields.NEGATIVE_TORQUE_LIMIT = 0;
		motor_info->motorRequestMessage.fields.POSITIVE_TORQUE_LIMIT = 0;
		motor_info->motorRequestMessage.fields.DRIVER_ENABLE = 0;
		motor_info->motorRequestMessage.fields.INVERTER_ENABLE = 0;
		*motor_state = WAITING_FOR_QUIT_INVERTER_OFF;
		break;
	case WAITING_FOR_QUIT_INVERTER_OFF:
		if (!feedback.fields.QUIT_INVERTER)
			*motor_state = READY_TO_SET_DC_OFF;
		break;
	case READY_TO_SET_DC_OFF:
		motor_info->motorRequestMessage.fields.DC_ENABLE = 0;
		*motor_state = WAITING_FOR_QUIT_DC_OFF;
		break;
	case WAITING_FOR_QUIT_DC_OFF:
		if (!feedback.fields.QUIT_DC_ON)
			*motor_state = MOTOR_DISABLED;
		break;

	default: break;
	};

	// Send the updated motor settings to the inverter
	CANQueueMessageToSend(motor_info->motorRequestMessageEntry, motor_info->motorRequestMessage.as_u64, motor_info->canInterface);
}
