ZipsRacingElectric/VCU-ZR25-Senior-Design/VCU-ZR25/Core/Src/fault_mgmt.c

/*
 * fault_mgmt.c
 *
 *  Created on: Feb 21, 2025
 *      Author: John
 */

/*
 * TODO:
 * - CAN comm for bms, strain gauge
 * - determine fault functionality
 */

#include "fault_mgmt.h"
#include "vehicle_fsm.h"
#include "driver_sensors.h"
#include "torque_ctrl.h"
#include "vehicle_data.h"

#define IMPLAUSIBILITY_TIMEOUT osKernelGetSysTimerFreq()/10

const uint8_t fault_critical[NUM_FAULTS] = {
	1, 0, 1, // critical
	0, 0, 0, 0, 0, 0, 0, 0 // non-critical
    //1, // critical
    //0, 0, 0, 0, 0, 0, 0, 0, 0, 0 // non-critical
};

static uint32_t apps_bps_implausibility_timer = 0;
static uint32_t sas_implausibility_timer = 0;
static bool apps_bps_implausibility_detected = 0;
static bool sas_implausibility_detected = 0;
static osThreadId_t thread_id;

FaultType_t faultsToClear = {.faultBits = FAULTS_NONE};

void update_fault_management_data(FaultType_t fault){
	osMutexAcquire(vdb_faulttask_lockHandle, osWaitForever);
	VehicleData.faultmgmt = fault;
	osMutexRelease(vdb_faulttask_lockHandle);
}

void StartFaultTask(void *argument){
	thread_id = osThreadGetId();
	FaultType_t fault = {.faultBits = FAULTS_NONE};
	osThreadFlagsSet(thread_id, fault.faultInt);
	for(;;){
		fault.faultInt = osThreadFlagsGet();

		fault_check();
		fault_callback();
		fault_clear_flags();
		update_fault_management_data(fault);

		osDelay(FAULT_MGMT_TASK_PERIOD);
	}
}

void fault_callback(){
	FaultType_t fault = {.faultBits = FAULTS_NONE};
	fault.faultInt = osThreadFlagsGet();

	uint32_t criticalFaults = 0;
	uint32_t nonCriticalFaults = 0;

	for (uint8_t i = 0; i < NUM_FAULTS; i++) {
		if (fault.faultInt & (1 << i)) {
			if (fault_critical[i]) {
				criticalFaults |= (1 << i);
			} else {
				nonCriticalFaults |= (1 << i);
			}
		}
	}

	if(criticalFaults){
		fsm_flag_callback(FLAG_INDEX_FAULT_DETECTED, 1);
	}
	else {
		fsm_flag_callback(FLAG_INDEX_FAULT_DETECTED, 0);
	}

	if(nonCriticalFaults || criticalFaults){
		DashboardFaultCallback(1);
	}
	else {
		DashboardFaultCallback(0);
	}
}

void fault_check(){
	FaultType_t fault = {.faultBits = FAULTS_NONE};

	apps_bps_implausibility_check(&fault);
	sas_implausibility_check(&fault);
	gps_check(&fault);
	inverter_check(&fault);
	bms_check(&fault);
	vcu_check(&fault);
	strain_gauge_check(&fault);

	osThreadFlagsSet(thread_id, fault.faultInt);
}

void apps_bps_implausibility_check(FaultType_t *fault){
	VehicleData_t local_vehicle_data = {0};

	osMutexAcquire(vdb_apps_lockHandle, osWaitForever);
	local_vehicle_data.apps = VehicleData.apps;
	osMutexRelease(vdb_apps_lockHandle);

	osMutexAcquire(vdb_bps_front_lockHandle, osWaitForever);
	local_vehicle_data.bps_front = VehicleData.bps_front;
	osMutexRelease(vdb_bps_front_lockHandle);

	osMutexAcquire(vdb_bps_rear_lockHandle, osWaitForever);
	local_vehicle_data.bps_rear = VehicleData.bps_rear;
	osMutexRelease(vdb_bps_rear_lockHandle);

	if (!local_vehicle_data.apps.plausible | !local_vehicle_data.bps_front.plausible
			| !local_vehicle_data.bps_rear.plausible) {

		if (!apps_bps_implausibility_detected) {
			apps_bps_implausibility_timer = osKernelSysTick();
			apps_bps_implausibility_detected = 1;
		}
		if (osKernelSysTick() - apps_bps_implausibility_timer >= IMPLAUSIBILITY_TIMEOUT) {
			fault->faultBits.Fault_apps_bps = 1;
			torque_fault_callback(1);
		}
	}
	else {
		apps_bps_implausibility_detected = 0;
		torque_fault_callback(0);
		faultsToClear.faultInt |= (1 << FAULT_INDEX_APPS_BPS_FAILURE);
	}
}

void sas_implausibility_check(FaultType_t *fault){

	VehicleData_t local_vehicle_data = {0};

	osMutexAcquire(vdb_sas_lockHandle, osWaitForever);
	local_vehicle_data.sas = VehicleData.sas;
	osMutexRelease(vdb_sas_lockHandle);

	if (!local_vehicle_data.sas.plausible) {

		if (!sas_implausibility_detected) {
			sas_implausibility_timer = osKernelSysTick();
			sas_implausibility_detected = 1;
		}
		if (osKernelSysTick() - sas_implausibility_timer >= IMPLAUSIBILITY_TIMEOUT) {
			ControlMode_t ctrl_mode = 0;
			fault->faultBits.Fault_ss = 1;
			update_control_mode(ctrl_mode);
		}
	}
	else {
		sas_implausibility_detected = 0;
		faultsToClear.faultInt |= (1 << FAULT_INDEX_SS_FAILURE);

	}
}

void gps_check(FaultType_t *fault) {
	uint32_t gps_plausible = 1;
	VehicleData_t local_vehicle_data = {0};

	osMutexAcquire(vdb_gps_lockHandle, osWaitForever);
    local_vehicle_data.gps = VehicleData.gps;
	osMutexRelease(vdb_gps_lockHandle);

	if (local_vehicle_data.gps.gps_status != GPS_3D && local_vehicle_data.gps.gps_status != GPS_2D) {
		gps_plausible = 0;
	}

	if (local_vehicle_data.gps.heading_motion > GPS_HEADING_MOTION_MAX || local_vehicle_data.gps.heading_motion < GPS_HEADING_MOTION_MIN ||
			local_vehicle_data.gps.heading_vehicle > GPS_HEADING_VEHICLE_MAX || local_vehicle_data.gps.heading_vehicle > GPS_HEADING_VEHICLE_MIN) {
		gps_plausible = 0;
	}

	if (local_vehicle_data.gps.z_angle_rate > GPS_YAW_RATE_MAX ||
			local_vehicle_data.gps.z_angle_rate < GPS_YAW_RATE_MIN) {
		gps_plausible = 0;
	}

	if (local_vehicle_data.gps.x_acceleration < GPS_ACCEL_X_MIN || local_vehicle_data.gps.x_acceleration > GPS_ACCEL_X_MAX) {
		gps_plausible = 0;
	}

	if ((local_vehicle_data.gps.y_acceleration * GPS_ACCEL_Y_INVERT) < GPS_ACCEL_Y_MIN || local_vehicle_data.gps.y_acceleration > GPS_ACCEL_Y_MAX) {
		gps_plausible = 0;
	}

	if(!gps_plausible) {
		fault->faultBits.Fault_gps = 1;
		update_control_mode(0);
	}
	else {
		faultsToClear.faultInt |= (1 << FAULT_INDEX_GPS_FAILURE);
	}
}

// not sure what to check
void inverter_check(FaultType_t *fault){
	if (0) { // fault detected
		fault->faultBits.Fault_inverter = 1;
	}
	else {
		faultsToClear.faultInt |= (1 << FAULT_INDEX_INV_FAILURE);
	}
}

void bms_check(FaultType_t *fault){
	uint32_t bms_plausible = 1;
	VehicleData_t local_vehicle_data = {0};

	osMutexAcquire(vdb_defaultTask_lockHandle, osWaitForever);
	local_vehicle_data.bms = VehicleData.bms;
	osMutexRelease(vdb_defaultTask_lockHandle);

	if (local_vehicle_data.bms.battery_temp < BMS_TEMP_MIN || local_vehicle_data.bms.battery_temp > BMS_TEMP_MAX) {
		bms_plausible = 0;
	}

	if (local_vehicle_data.bms.dc_bus_voltage < BMS_VOLTAGE_MIN || local_vehicle_data.bms.dc_bus_voltage > BMS_VOLTAGE_MAX) {
		bms_plausible = 0;
	}

	if (local_vehicle_data.bms.instantaneous_power < BMS_POWER_MIN || local_vehicle_data.bms.instantaneous_power > BMS_POWER_MAX) {
		bms_plausible = 0;
	}

	if (local_vehicle_data.bms.soc < BMS_SOC_MIN || local_vehicle_data.bms.soc > BMS_SOC_MAX) {
		bms_plausible = 0;
	}

	local_vehicle_data.bms.plausible = bms_plausible;

	if (!bms_plausible) {
		fault->faultBits.Fault_bms = 1;
		update_control_mode(0);
	}
	else {
		faultsToClear.faultInt |= (1 << FAULT_INDEX_BMS_FAILURE);
	}
}

// not sure what this would be
void vcu_check(FaultType_t *fault){
	if (0) { // fault detected
		fault->faultBits.Fault_vcu = 1;
	}
	else {
		faultsToClear.faultInt |= (1 << FAULT_INDEX_VCU_FAILURE);
	}
}

void strain_gauge_check(FaultType_t *fault) {
	uint8_t strain_plausible = 1;
	VehicleData_t local_vehicle_data = {0};

	osMutexAcquire(vdb_defaultTask_lockHandle, osWaitForever);
	local_vehicle_data.bms = VehicleData.bms;
	osMutexRelease(vdb_defaultTask_lockHandle);

	if (local_vehicle_data.strain_gauge.fl_tire_load < STRAIN_FL_LOAD_MIN || local_vehicle_data.strain_gauge.fl_tire_load > STRAIN_FL_LOAD_MAX) {
		strain_plausible = 0;
	}

	if (local_vehicle_data.strain_gauge.fr_tire_load < STRAIN_FR_LOAD_MIN || local_vehicle_data.strain_gauge.fr_tire_load > STRAIN_FR_LOAD_MAX) {
		strain_plausible = 0;
	}

	if (local_vehicle_data.strain_gauge.rl_tire_load < STRAIN_RL_LOAD_MIN || local_vehicle_data.strain_gauge.rl_tire_load > STRAIN_RL_LOAD_MAX) {
		strain_plausible = 0;
	}

	if (local_vehicle_data.strain_gauge.rr_tire_load < STRAIN_RR_LOAD_MIN || local_vehicle_data.strain_gauge.rr_tire_load > STRAIN_RR_LOAD_MAX) {
		strain_plausible = 0;
	}

	local_vehicle_data.strain_gauge.plausible = strain_plausible;
	if (!strain_plausible) {
		fault->faultBits.Fault_strain_gauge = 1;
	}
	else {
		faultsToClear.faultInt |= (1 << FAULT_INDEX_STRAIN_GAUGE_FAILURE);
	}
}

void fault_clear_flags(){
	osThreadFlagsClear(faultsToClear.faultInt);
	faultsToClear.faultBits = FAULTS_NONE;
}

void fault_flag_callback(uint8_t fault, uint8_t value){
	FaultType_t faults = {.faultBits = FAULTS_NONE};
	if (value){
		if(fault == (FAULT_INDEX_BMS_COM_FAILURE | FAULT_INDEX_GPS_COM_FAILURE)){
			ControlMode_t ctrl_mode = 0;
			update_control_mode(ctrl_mode);
		}
		else if (fault == FAULT_INDEX_INV_COM_FAILURE){

		}
		else if (fault == FAULT_INDEX_STRAIN_GAUGE_COM_FAILURE)
    	faults.faultInt |= (1 << fault);
    }
    else{
		faultsToClear.faultInt |= (1 << fault);
    }

    osThreadFlagsSet(thread_id, faults.faultInt);
}
