ZipsRacingElectric/VCU-ZR25-Senior-Design/VCU-ZR25/Core/Inc/cooling_system.h

/*
 * cooling_system.h
 *
 *  Created on: Feb 21, 2025
 *      Author: John
 */

#ifndef INC_COOLING_SYSTEM_H_
#define INC_COOLING_SYSTEM_H_

#include "cmsis_os.h"

#define COOLING_TASK_PERIOD 50
#define MAX_TEMP_THRESHOLD 45 // Max and Min based off requirement 1.1.12
#define MIN_TEMP_THRESHOLD 30

void StartCoolingTask(void *argument);
void CoolingSystemTurnOnLeft();
void CoolingSystemTurnOnRight();
void CoolingSystemTurnOffLeft();
void CoolingSystemTurnOffRight();

#endif /* INC_COOLING_SYSTEM_H_ */
