ZipsRacingElectric/VCU-ZR25-Senior-Design/(commit log)

2024-09-19 Initial Commit
    Default project, STM32F405RTG6 target device
2024-09-19 Revert "Initial Commit"
    This reverts commit 63238fed170f4ba92f23810b71c125070779bea5.
    [main.c, main.h]
2024-09-19 Base Project
    target: STM32F405RTG6
2024-11-13 Sensor Demo Initial Commit
    Added USB VCOM functionality
2024-11-15 Driver input sensor functions
    Basic APPS functionality. TODO: steering angle driver and calibration functions
2024-11-15 Driver sensor interface functions
    also updated brake pressure default max
2024-11-15 APPS calibration
2024-11-18 Brake pressure calculation
2024-11-19 Steering Angle Sensor
    device setup and driver structure
2024-11-20 Updated demo output
    fixed some pedal position bugs
    [am4096_encoder.c, am4096_encoder.h, driver_sensors.c, main.c]
2025-01-28 Updated driver sensor tests
2025-01-28 Added VCU schematic
2025-02-11 Demo add, FSM update
    Adding my demo (broken) and also updated fsm conditions and some pin assignments
    [main.c, main.h, powersupply.ioc]
2025-02-11 Bring in Sensors
    Broken, just starting
    [main.c]
2025-02-11 Bring in power supply
    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
    [main.c]
2025-02-14 Factor Out Power Supply
2025-02-14 Factor Out Driver Sensors
2025-02-18 Use flags to communicate from GPIO interrupt to FSM
2025-02-19 Add a lock for the power supply data
2025-02-19 Edit the power supply and driver sensor tasks
2025-02-19 Change function signature for driver sensor task
2025-02-19 Initial Update to GPIO Pins and FSM
    Updated all defines of GPIO pins, though I didn't change the .ioc file yet
    Updated FSM based on discussion and issue
    [VCU-ZR25.ioc, amk_can.h, gpio.h, main.c, vehicle_fsm.c, vehicle_fsm.h]
2025-02-19 Fixing Compilation Issues
    Not done
    [driver_sensors.h, gpio.h, main.c, power_supply.c, power_supply.h, vehicle_data.c, vehicle_data.h]
2025-02-19 Update VCU-ZR25.ioc
    Correct and add all pins to the .ioc
    [VCU-ZR25.ioc]
2025-02-20 Define ADC callback
    Put in block for callback, needs to be changed to requirements. Changed flags initialized to the thread flags so they don't wipe flags previously set
2025-02-20 FSM Updates
    Put the defines for driver_sensor.c into the .h file for now so that fsm can determine by adc callback.
    Didn't understand the osThreadFlagsSet was an OR operation, consequently added flag clears
    [driver_sensors.c, driver_sensors.h, vehicle_fsm.c]
2025-02-20 Enable CAN RX interrupts
2025-02-20 Fixed branch compilation error
    Also commented out ADC callback because I don't know how to do it yet and it can be addressed in the motor torque or fault detection issues
    [main.c, vehicle_fsm.c]
2025-02-21 Create fsm flag callback for systems
    Added a callback different systems can use to set or clear flags on the fsm. Added braking and plausibility to the driver_sensor callback. Though the plausibility should probably be removed and a fault callback should be defined instead so the fsm can operate depending on the fault
2025-02-21 VCU Fault Pin Write
    Also removed redundant flag
2025-02-21 Fix some errors on amk_can
    [amk_can.c, amk_can.h]
2025-02-22 Add VehicleData_t Updates and Power Supply Updates
    Now all systems have a call to update the vehicle data (besides the AMKState_t)
    GLV_BATTERY_PIN is an ADC, so I took that out of fsm gpio callbacks and added a callback in power supply for that. Updated power supply voltage thresholds
    Fixed typo in the fsm TransitionState
    [driver_sensors.c, power_supply.c, power_supply.h, vehicle_fsm.c]
2025-02-22 Brake Threshold Update
    Changed the fsm callback to flag fsm based on the minimum brake pressed, toggles brake light
    Renamed the mechanical brakes engaged threshold, should be defined/set further in fault management and handled in CAN
2025-02-22 Update Cooling System
    Just needs the CAN implementation for getting the temperatures and scaling factors / units
2025-02-22 Create Dashboard Task
    Needs CAN functionality, also update when torque handler is done, and will need callback from fault handler for non critical faults
2025-02-24 Update Driver Sensor ADC Channels
2025-02-24 Create Torque Control Task
2025-02-27 dfu_test for checking if board works
2025-03-08 Initial commit of PID implementation
    PID discretized with Tustin method, includes optional 1st order filter on Kd term.
2025-03-11 Fix typos in task definitions
    [VCU-ZR25.ioc, driver_sensors.c, driver_sensors.h, main.c, power_supply.c, power_supply.h, vehicle_fsm.c]
2025-03-11 Fix fsm delay
    osThreadFlagsWait was clearing the os flags to {0} resulting in no updates to the fsm flags
    [vehicle_fsm.c, vehicle_fsm.h]
2025-03-13 Simple motor feedback-request loop implemented
2025-03-17 Updated schematic
2025-03-18 Update TODO's
    Condense TODO's to top of each file, also implemented hard braking condition and pedal travel implausibility in driver_sensors
2025-03-18 Fault Updates
    added all faults
    apps_bps fault: needs to send 0 torque
    ss_fault done
2025-03-18 Fault Updates
    Added rest of fault checks
    Updated fsm to turn on/off 5v
    Updated dashboard to turn on/off input
2025-03-18 Update dashboard
    Fix gpio input/output switch for dash input 1
    [dashboard.c]
2025-03-18 Update aps/bps implausibility
    Added torque fault callback to set torque percent to 0 for now, updated the limit functions to operate properly
2025-03-18 Update 5V enable
2025-03-18 Update 5V set
2025-03-20 Implement motor feedback reception
2025-03-20 Fixup some inverter-related code
    [amk_can.c, amk_can.h, can_db.c]
2025-03-20 Enable Interrupts for button inputs
2025-03-21 Dash Input 2 Interrupt
2025-03-21 Measure time between motor feedback messages for fault detection
2025-03-21 GPIO Updates
    Updated driver sensor define value format and BPS for testing
    Updated thread clears (which is not confirmed to work rn)
    Switched back glv_battery to the ADC as that was an accident
2025-03-31 Saving Code State That Isn't Broken
    [driver_sensors.h, fault_mgmt.c, main.c, power_supply.h, vehicle_fsm.c]
2025-03-31 Fix Clearing Flags
    Fixed Clearing of the Flags:
    It was not clearing properly awhile ago with the osThreadFlagsWait, so I had switched to just osThreadFlagsClear. This wouldn't work because the "osFlagsNoClear" option has to be setin the wait function. I added this and then needed the manual flag clearing to occur before this wait function, as clearing them within the functions that update flags will not register before the wait function clears the flags again.
    Also changed the reset and start button to rising/falling to trigger correctly, probably need to be done similarly to the other GPIO interrupts. This is not reflected in main because my laptop can't generate code correctly.
    [VCU-ZR25.ioc, vehicle_fsm.c, vehicle_fsm.h]
2025-04-01 Fix Fault Flags and Update Input Configs
    [VCU-ZR25.ioc, fault_mgmt.c, fault_mgmt.h]
2025-04-02 Vehicle Data Updates
    Added FaultType_t to vehicle data, fixed fault_mgmt usage of vehicle data
    Also minor fixes in driver sensors and torque control when testing
    [driver_sensors.c, fault_mgmt.c, fault_mgmt.h, main.c, torque_ctrl.c, vehicle_data.c, vehicle_data.h]
2025-04-02 Avoid memery errors caused by sending local variable pointers as task arguments
    [main.c]
2025-04-02 Create read-only torque control parameter block & reprogramming function
2025-04-06 Add LUTs for torque dist algorithm & LUT access functions
2025-04-06 Added public function prototype that was missing
    [tuning_params.h]
2025-04-07 Firmware for testing PID implementation with Simulink
2025-04-07 Fix bug in get_index & clamp rather than fault on OOB
    [lut.c, lut_utils.h]
2025-04-07 Remove error checks on lookup functions since get_index no longer returns errors
    [lut_utils.h]
2025-04-07 Update can flags, critical faults
    Add the osFlagsNoClear to can flag waits so it continues
    Added inv com failure to critical to show for testing
    [amk_can.c, can_db.c, fault_mgmt.c, fault_mgmt.h]
2025-04-08 Add torque unit conversion to amk_can
2025-04-08 Record motor temperature and power consumption stats in AMKState_t
2025-04-08 Remove 5V check, update fault dashboard callback
2025-04-08 Configure CAN IDs for all motors
2025-04-08 Update Cooling System, Add CAN Torque Setting
2025-04-08 Implement GPS/IMU sensor
2025-04-08 Adjust torque math
2025-04-09 Yaw Controller with gain scheduling
2025-04-09 Fixed issue with can filters - HIL test
    [main.c]
2025-04-10 Add GPS & FSM to driver_sensors printout
2025-04-10 Updates
    Locks for all statements touching vehicledata
    Add buzzer control setting
    Don't allow torque outputs unless ready to drive
    Add defaulttask lock just for bms and straing gauge reads
    Enable -u_printf_float
    [VCU-ZR25.ioc, cooling_system.c, driver_sensors.c, fault_mgmt.c, main.c, torque_ctrl.c, vehicle_data.h, vehicle_fsm.c]
